tihonov-e/Integrated_Servodriver/Doc/Hall board.PNG

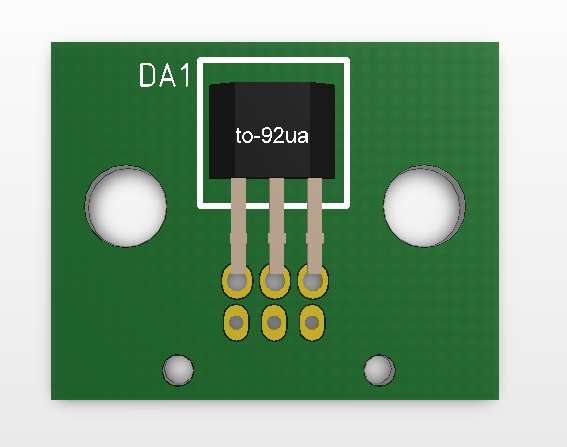
Doc/Hall board.PNG
