tihonov-e/Integrated_Servodriver/Altium Project/Supply Unit/Архив/ver.2/supply board concept.pdf

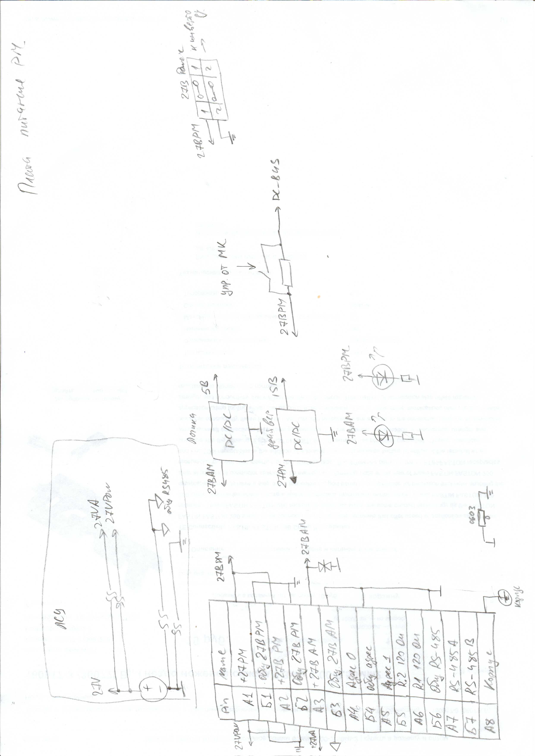
[picture p2: page 1]
