tihonov-e/Integrated_Servodriver/Расчеты/Кинематический расчет Рубеж движок ДБУ 36-3,2-24 снижение тока.pdf

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
:= | J | h

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
:= | deg
0 | 10 | 20 | 30 | 40
- 20
- 10

10

20

Циклограмма нагрузки

P
J

h
deg

Параметры РВП

Уравнение движения

hmax := max(h) = 36·deg

tmax := 0.4s

v

hmax

tmax

:= | = 15·rpm

Момент трения в подшипнике по линейной зависимости

момент трения Mbear

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
:= J

при усилиий PMb

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
:= | J
- 20 | - 10 | 0 | 10 | 20
- 1
- 0.5

0

0.5

1

Mbear

PMb

Передаточное отношение
планетарки | | i
| | cherv := 33

i

pr | 4 i
cherv := · | = 132 | η := 0.95·0.7 = 0.665 | i
pr_1 | i
pr := | = 132
лопасть | рвр до червяка черв | гайка

JΣ

0.008kg m

| 2
| ·

i
pr

2

| | 0.152 10⁻ ⁶
| | · kg m
| | 2
| + | · 3 10⁻ ⁵
| | · kg m

2
·
| | i pr

2

+

2.58 10⁻ ⁵
- kg m

2
·

i
cherv

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
·1 0.637 kg mm

2
:= | = | · ·

tmax = 0.4s

Φ(t) | 1 if t ≥ 0
| 0 otherwise

:=
20

t
1
:= 70ms | t
2

:= 70ms

ωmax1

hmax

tmax 0.5 t
1
- | · | 0.5 t
2
- ·

109.1 deg
s
:= | = | ·

ωmax

hmax i
pr ·

tmax 0.5 t
1
- | · | 0.5 t
2
- ·
:= | = 2400·rpm

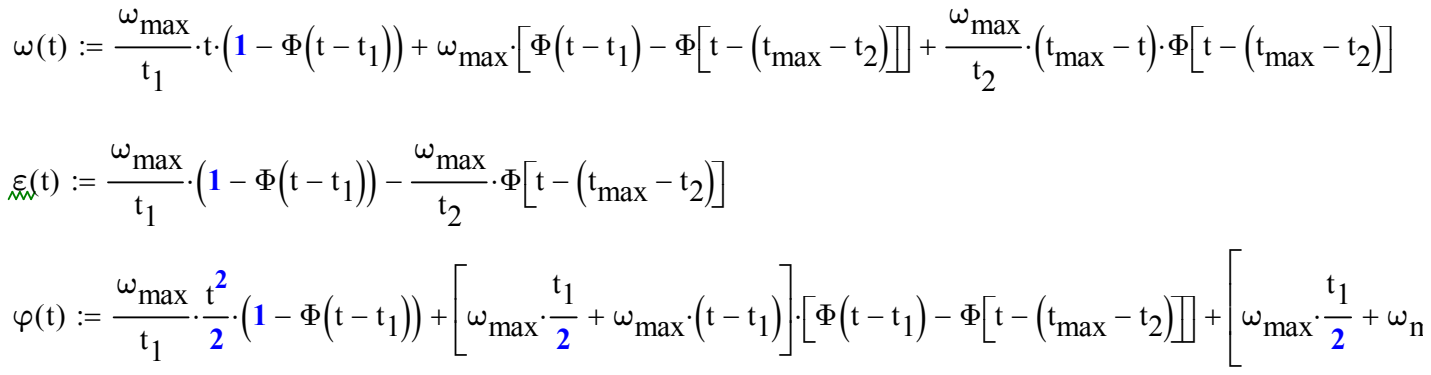
[picture p3: figure]
ωmax; ·( - ( - )) ωmax Φ t t; tmax t; tmax ·(; )) ωmax; ωmax t; · ωmax +
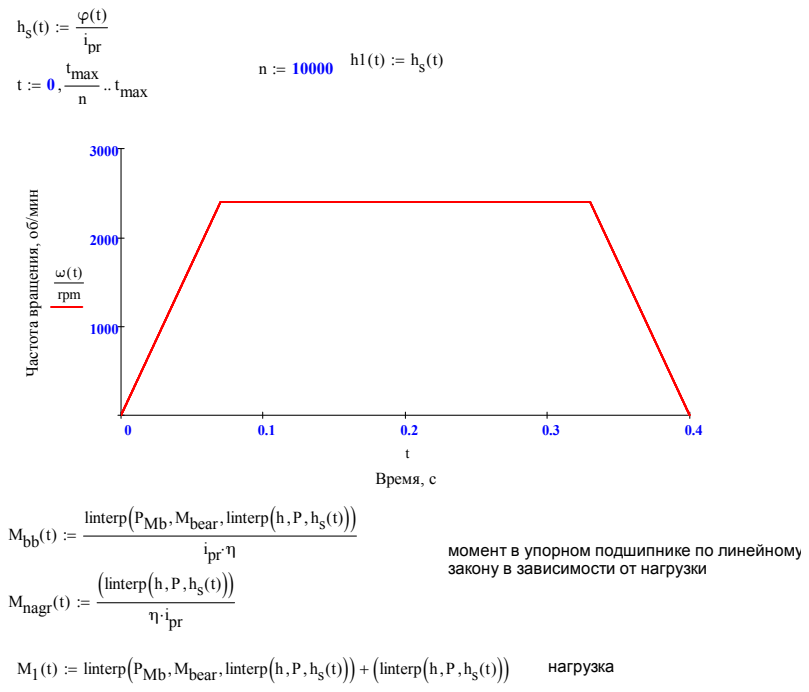
[picture p4: page 3]
tmax; tmax :=; Время, с; rpm; Mbb(t); linterp PMb Mbear ,; linterp h, P hs (; Mnagr(t); linterp h, P h; ( , (t))) linterp h, P h; нагрузка

Частота вращения, об/мин

момент в упорном подшипнике по линейному
закону в зависимости от нагрузки

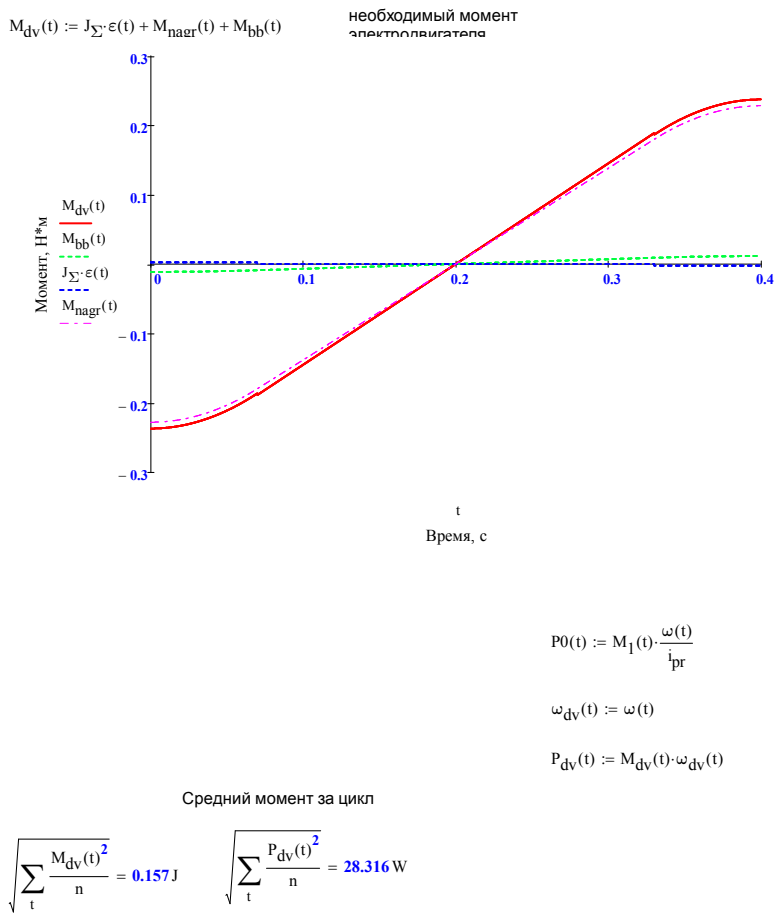
[picture p5: page 4]
необходимый момент электродвигателя; Mdv(t); Mnagr +; Mbb :=; Время, с; Момент, Н*м; Mbb(t); Mnagr(t); ωdv(t) := ω(t); Pdv(t); Mdv(t) ωdv :=

Средний момент за цикл

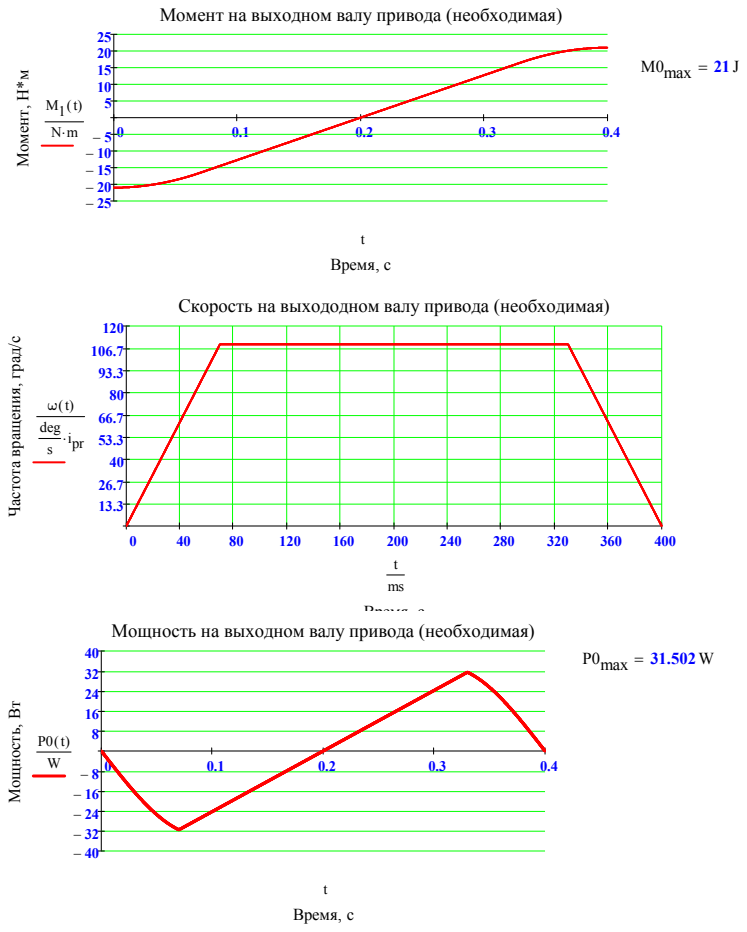
[picture p6: page 5]
Время, с; Момент, Н*м; M0max = 21 J; deg; ipr ·; Мощность на выходном валу привода (необходимая); Мощность, Вт; P0max = 31.502W

Момент на выходном валу привода (необходимая)

Скорость на выхододном валу привода (необходимая)

Частота вращения, град/с

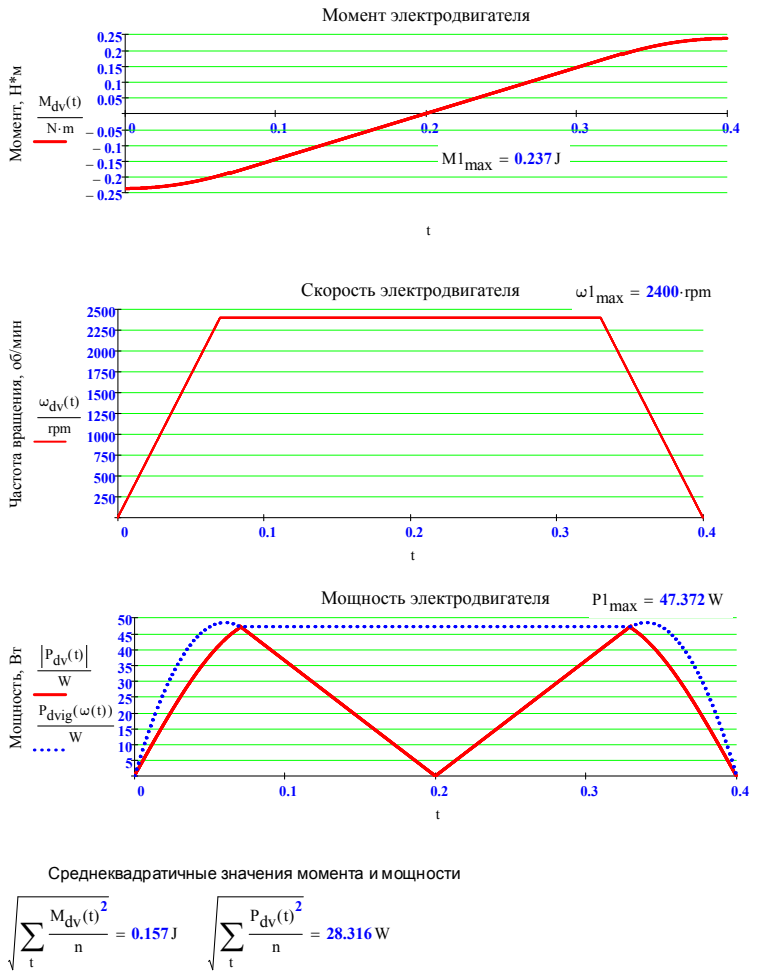
[picture p7: page 6]
Момент электродвигателя; Момент, Н*м; Mdv(t); M1max = 0.237J; Скорость электродвигателя; ωdv(t); rpm; ω1max = 2400·rpm; Мощность электродвигателя; Мощность, Вт; Pdv(t); Pdvig(ω(t)); P1max = 47.372W

Частота вращения, об/мин

Среднеквадратичные значения момента и мощности

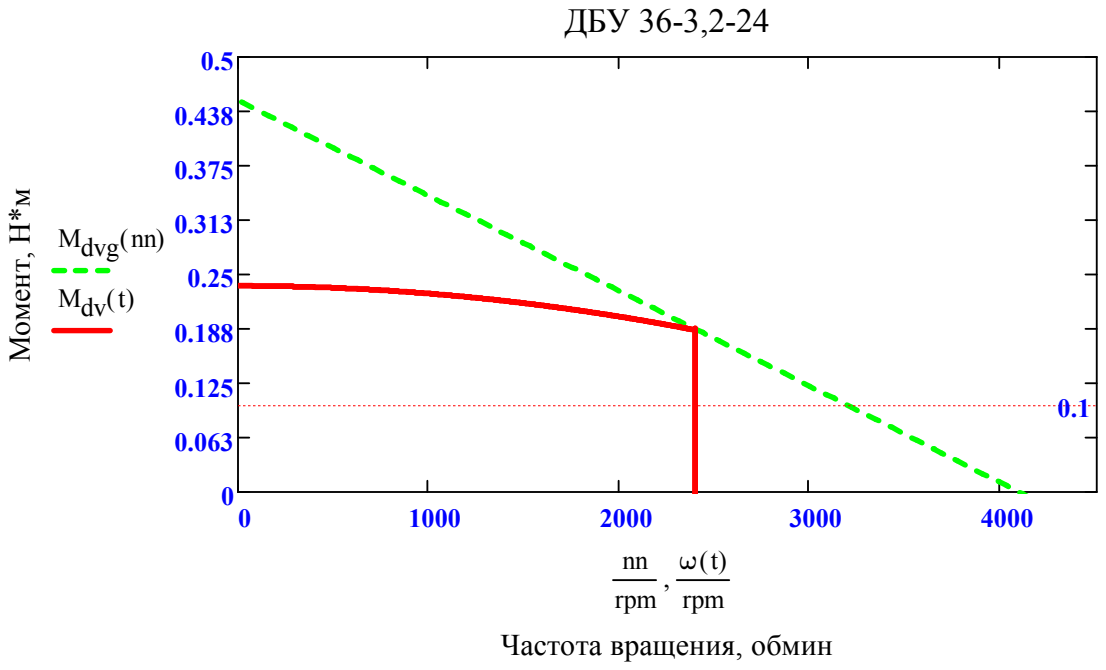
[picture p8: figure]
ДБУ 36-3,2-24; Частота вращения, обмин; Момент, Н*м; Mdvg(nn); Mdv(t); rpm

ipr_1 = 132 | передаточное отношение

максимальная мощность P1max = 47.372W

| максимальная скорость на входном валу привода
ω1max = 2400·rpm
M1max = 0.237J | максимальный момент на входном валу привода

среднеквадратичный момент на входном валу привода

t

Mdv(t)

2
∑ n
= 0.157J

среднеквадратичная мощность на входном валу привода

t

Pdv(t)

2
∑ n
= 28.316W

характеристики электродвигателя Mdvig

0.45

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
= | J | ndvig

0

3200

4100

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
= | ·rpm

мощности электродвигателя
ndvig Mdvig ·

¾¾¾¾→¾

0

33.51

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
= | W

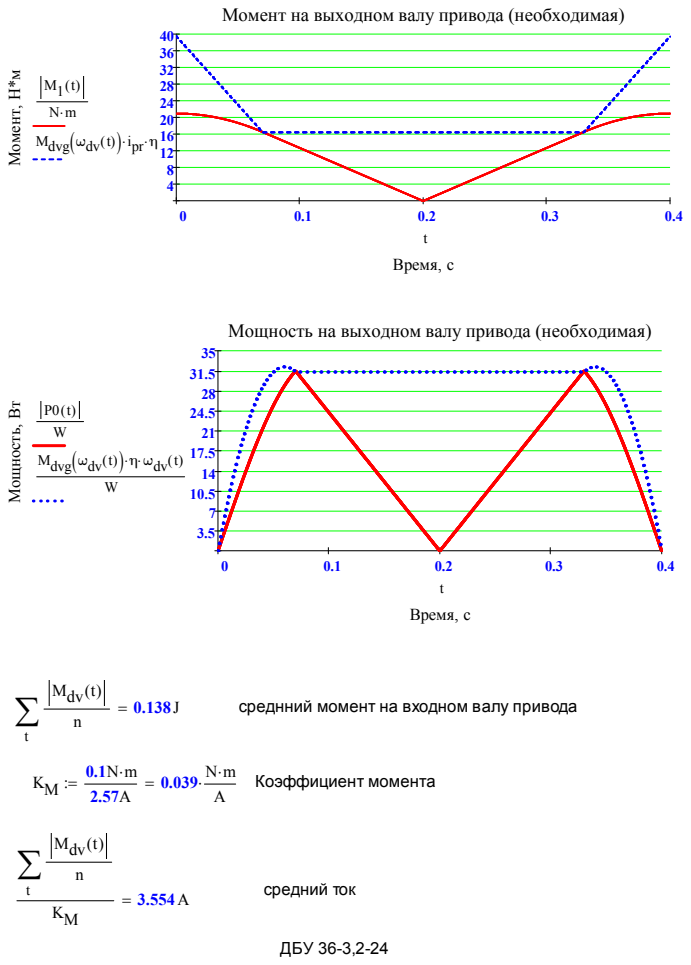
[picture p9: page 8]
Время, с; Момент, Н*м; Mdvg ωdv ( (t)) ipr ·; Мощность на выходном валу привода (необходимая); Мощность, Вт; Mdvg ωdv ( (t))·η ωdv ·; Mdv(t) ∑ n; среднний момент на входном валу привода; Коэффициент момента; средний ток; ДБУ 36-3,2-24

Момент на выходном валу привода (необходимая)

21J·90

deg
s
0.5

= 65.973W

0.98⁶

0.99⁶
- = 0.834

max

tmax

t
1

t
2

·

(

)

ωmax
t

tmax

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
ωmax
t
2

·

2

+

ùúúû

Φ
t

tmax

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
0 | 0.1 | 0.2 | 0.3 | 0.4
- 1000
- 500

500

1000

Время, с

Ускорение, 1/

с^2

ε(t)

rev

s

2

t

linterp h, P h

s ( ( , (t)))

1
0.5
- | Mbb + | (t)

Время, с

Мощность, Вт

57.687

- 57.703

Mdv(t)·ω(t)

0 | t | 0.4

Mdv

21J·90 deg
s
0.5

= 65.973W

1
tmax 0s

tmax
M | t

dv(t)

ó
ô
õ
- d = 0.138J

1
tmax 0s

tmax
M | t

dv(t)·ω(t)

ó
ô
õ
- d = 24.699W

t1 := 0.35s

ω1max := ω(ω1max) = 2400·rpm M0max := M1(M0max) = 21J

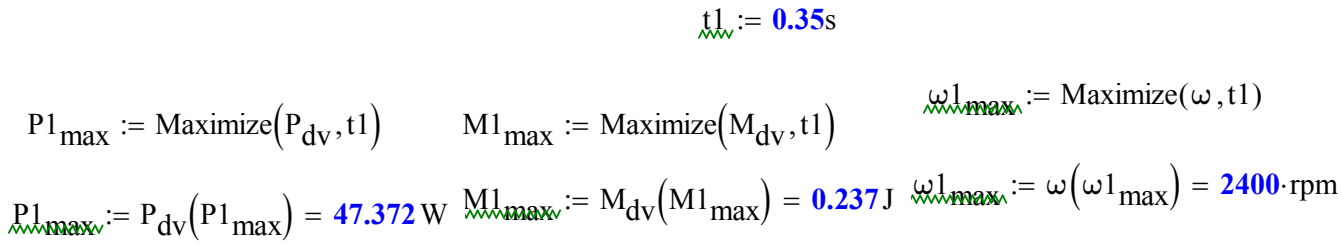
[picture p10: figure]
ω1max := Maximize(ω , t1); P1max; Maximize Pdv :=; M1max; Maximize Mdv :=; Pdv :=; (P1max) = 47.372W

ω1max := ω(ω1max) = 2400·rpm M1max := Mdv(M1max) = 0.237J

ndvig

0

3200

4100

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
:= | rpm Mdvig

0.45

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
:= | J

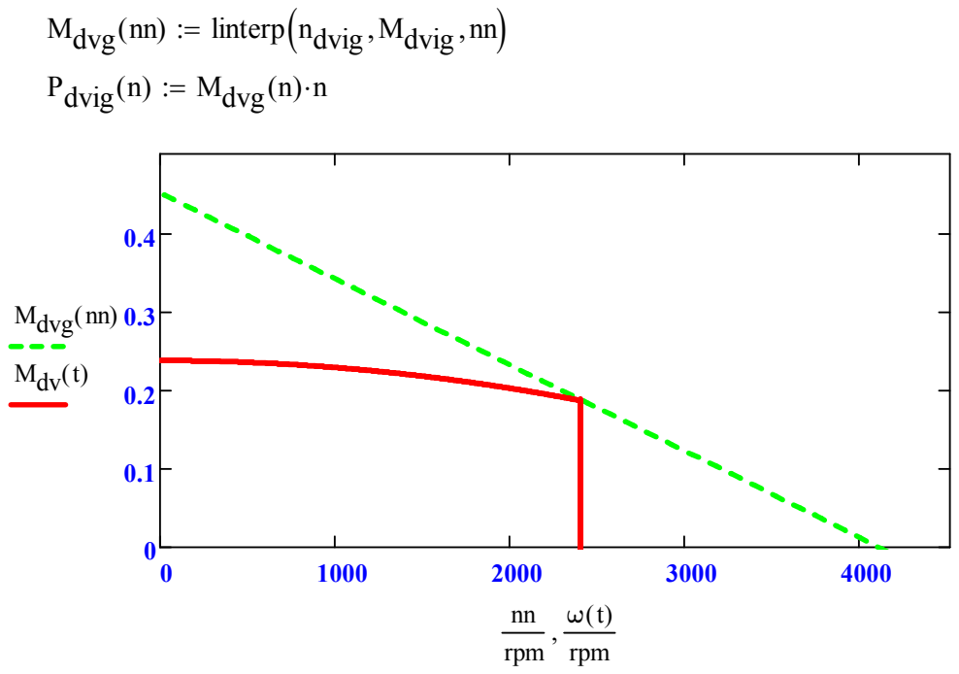
[picture p11: figure]
Mdvg(nn); linterp ndvig Mdvig :=; Pdvig(n); Mdvg :=; Mdv(t); rpm
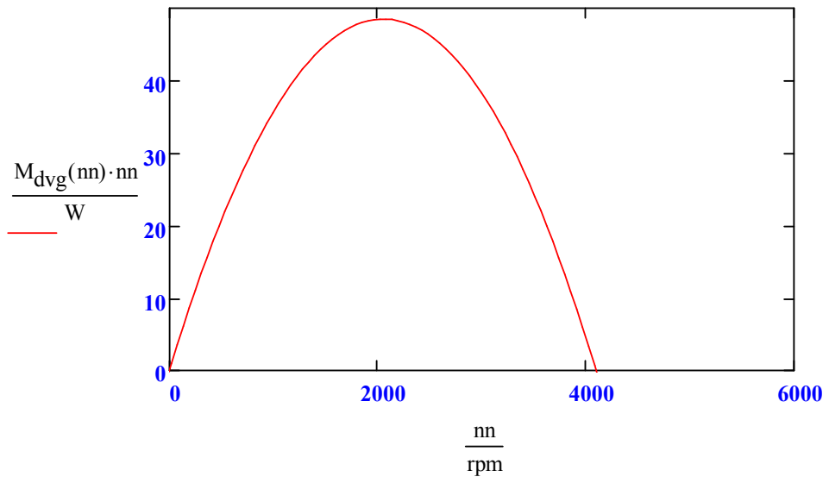
[picture p12: figure]
Mdvg(nn)·nn; rpm

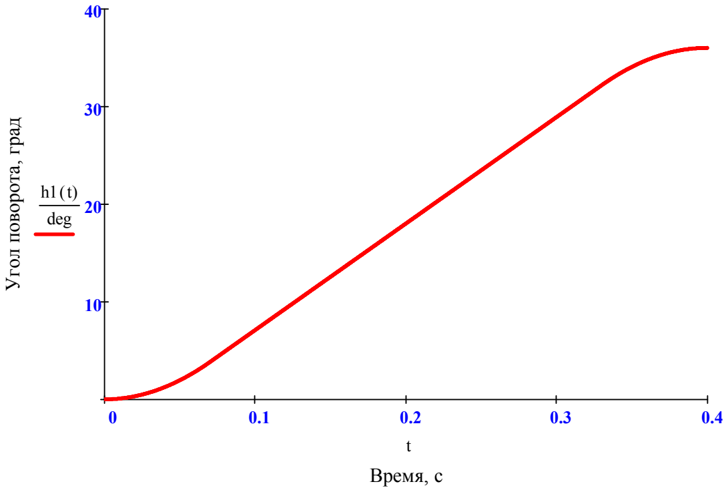
[picture p13: figure]
Время,; Угол поворота, град; deg

6800rpm·0.043J = 30.62W
