tihonov-e/Integrated_Servodriver/Doc/Структура МУ.pdf

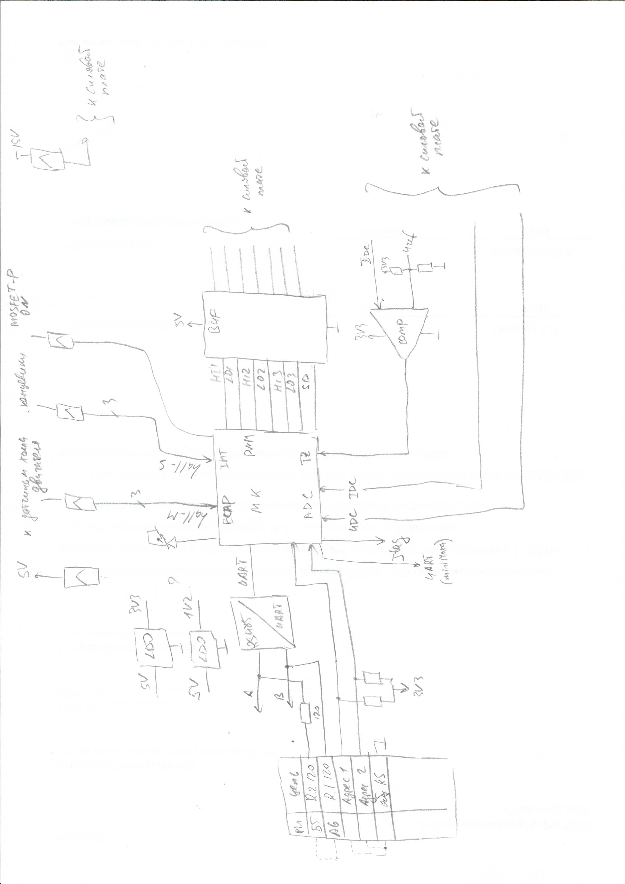
[picture p14: page 1]
