tihonov-e/Integrated_Servodriver/Расчеты/Графики нагрузки от Матвева/Максимальная нагрузка.jpeg

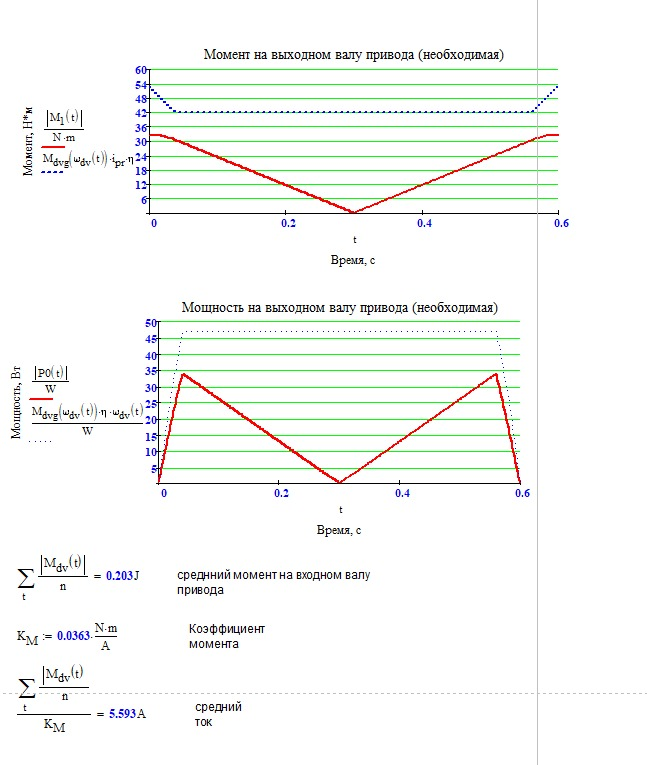
Расчеты/Графики нагрузки от Матвева/Максимальная нагрузка.jpeg
