tihonov-e/Integrated_Servodriver/Расчеты/Графики нагрузки от Матвева/Номинальная нагрузка.jpeg

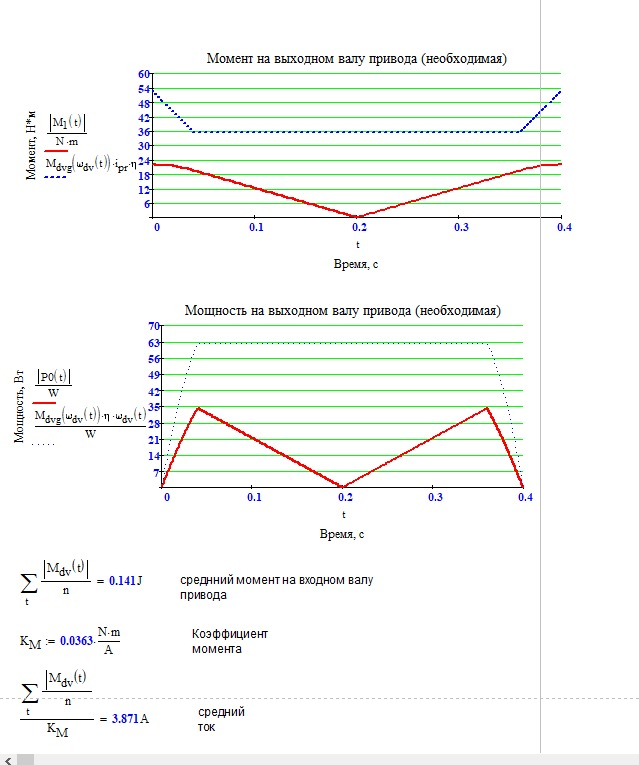
Расчеты/Графики нагрузки от Матвева/Номинальная нагрузка.jpeg
