tihonov-e/Integrated_Servodriver/Altium Project/Power Unit/Project Outputs for Power_unit-RM/Power_unit-RM.xls

Designator | PartNumber | Quantity | Manufacturer | MAX | Analog
C1, C2, C3 | К53-68 "С"-25 В-10 мкф ±10% | 3 | Элеконд
C4, C8, C15, C19, C32, C36 | К10-84в-3225М-25~В-Н20-1 мкФ-O-A ±10% ФЦТА.673516.016 ТУ | 6 | Monolit
C6, C10, C17, C21, C34, C38 | К10-84в-2012М-50В-0,1 мкФ +80/-20%-Н90-N-A | 6 | Монолит |  | 00131672 (pin-to-pin)
C7, C18, C35 | K73-17-63В-0,22мкФ±10%-В АЖЯР.673633.004 ТУ | 3 | Гириконд
C11, C12 | K50-93-63В-100мкФ ±20% -И-В АЖЯР.673541.021 ТУ | 2 | Элеконд | 00139211
C13, C24, C39 | К53-68 "А"-10 В-4.7 мкф | 3 | Элеконд | 00130629
C14, C23, C30, C40 | К10-79-10В-0,1 мкФ +80-20% H90 | 4 | Гириконд | 00131675
C22, C25, C26, C28, C29 | К10-84в-1608М-50В-0.01мк ±20%-Н20-N-A | 5 | Монолит |  | MAX 00131676 (pin-to-pin), MAX 00132726 (pin-to-pin), MAX 00131676 (pin-to-pin), MAX 00131676 (pin-to-pin), MAX 00131676 (pin-to-pin)
C27, C31 | К10-84в-1608М-50В-47 пФ ±10%-МП0-N-A | 2 | Монолит |  | 00124425 (pin-to-pin)
DA1 |  | 1 | НПП "Восток" | 00135502 | OP284FS
DD1, DD2, DD3 | 1308ЕУ4АУ | 3 | Кремний Эл | 00131005 | IR2113 IR
R1, R10, R29 | Р1-12-0,1ум.-10~Ом ±2%-М ШКАБ.434110.002 ТУ | 3 | ОАО Ресурс | 00133989
R2, R3, R4, R6, R9, R11, R12, R14, R21, R32, R33, R35, R37 | Р1-12-0,1ум.-10~кОм ±5%-М ШКАБ.434110.002 ТУ | 13 | ОАО Ресурс |  | MAX 00133986 (1%)
R5, R8, R13, R20, R34, R36 | Р1-12-0,125-20 Ом ±5%-М ШКАБ.434110.002 ТУ | 6 | ОАО Ресурс |  | MAX 00133867 (22Ом)
R7 | Р1-12-0,125-10~кОм ±1%-М ШКАБ.434110.002 ТУ | 1 | ОАО Ресурс | 00134578
R15, R16 | Р1-12-0,1ум.-28~кОм ±5%-М ШКАБ.434110.002 ТУ | 2 | ОАО Ресурс | 00134035
R17, R23, R25, R30 | Р1-12-0,1ум.-100~Ом ±5%-М ШКАБ.434110.002 ТУ | 4 | ОАО Ресурс | 00133991
R18 | Р1-12-0,1ум.-4.02~кОм±1%-М ШКАБ.434110.002 ТУ | 1 | ОАО Ресурс | 00134054
R19, R24, R28 | Р1-12-0,1ум.-1~кОм ±1%-М ШКАБ.434110.002 ТУ | 3 | ОАО Ресурс | 00133971
R22, R31 | Р1-12-0,1ум.-2.61~кОм±1%-М ШКАБ.434110.002 ТУ | 2 | ОАО Ресурс | 00134019
R26, R27 | Р2-105-0,75-0,1 Ом±1% А РМУ.434150.001 ТУ | 2 | Эркон | 00149850
VD1, VD5, VD7, VD9, VD11, VD15, VD16, VD17, VD18, VD19, VD20 | 2ДШ205А9 | 11 | ВЗПП Воронеж |  | MBR0580
VD2, VD6, VD12 | 2РС202Е91 | 3 | ВЗПП |  | SMBJ48CA (pin-to-pin)
VD3, VD4, VD8, VD10, VD13, VD14 | 2Р192В9 | 6 | КРИП |  | КР192А9 (ОТК) (pin-to-pin)
VT1, VT2, VT3, VT4, VT5, VT6 | 2ПЕ208В92 | 6 | Ангстрем |  | AnD28N10
XP1 | СНП401-6ВП21-3-1-1 | 1 | Электродеталь |  | MAX 00126397 (M80-5000605 pin-to-pin)
XP2 | СНП393-18ВП31-2-01-5 РЮМК.430420.035 ТУ | 1 | Электродеталь |  | MAX 000724477 (PLD-80R с доработкой до 18pin)
XT1 | СКПП-0.5-2.54У-3x2-2 СЦНК.434410.044 ТУ | 1 | Завод Атлант |  | 233-403 Wago
