tihonov-e/Integrated_Servodriver/Altium Project/Supply Unit/Project Outputs for Supply_unit-RM/Supply_unit-RM.xls

Designator | PartNumber | Value | Manufacturer | Quantity | MAX | Analog
C1, C8 | К53-68 "E"-50 В-10мкф ±10% | 10мк | Элеконд | 2 | 00145440 | 00132739 (pin-to-pin на 15мкФ)
C2, C9 | К53-68 "D"-25 В-22мкф ±10% | 22мк | Элеконд | 2 | 00132735
C3, C6 | К10-84в-3225М-25В-0,47 мкФ ±10%-Н20-N-A | 0.47мк | Монолит | 2 |  | MAX 00150226
C4, C5, C7, C10 | К10-84в-1608М-50В-10 нФ ±10%-Н20-N-A | 10000 | Монолит | 4
R1, R7, R12 | Р1-12-0,1ум.-3.16~кОм ±1%-М ШКАБ.434110.002 ТУ | 3.16k | ОАО Ресурс | 3 | 00134464
R3 | Р1-12-0,1ум.-0.15~Ом ±20%-М ШКАБ.434110.002 ТУ | 0.15 | ОАО Ресурс | 1 | 00133968 | MAX 00117169 pin-to-pin
R4, R13 | Р1-12-0,1ум.-10~кОм ±5%-М ШКАБ.434110.002 ТУ | 10k | ОАО Ресурс | 2 |  | MAX 00133986 (1%)
R8 | Р1-12-0,1ум.-680~Ом ±5%-М ШКАБ.434110.002 ТУ | 680 | ОАО Ресурс | 1 | 00134086
R9 | Р1-12-0,125-680 Ом ±5%-М ШКАБ.434110.002 ТУ | 680 | Ресурс | 1 | 00133924
R10, R11 | Р1-12-0,1ум.-4.02~кОм ±1%-М ШКАБ.434110.002 ТУ | 4.02k | ОАО Ресурс | 2 | 00123886
U1 | МДМ5-1В15НН |  | Aedon | 1
U2 | МДМ3-1В05НН |  | Aedon | 1
VD1, VD3 | 2Р245Е91 |  | НЗПП | 2 |  | SMA6J33A
VD5, VD6 | ИПД169А9-Л |  | Протон | 2 |  | MAX 00129484 КР-1608 Kingbright (pin-to-pin)
VD7 | 2Р192В9 |  | КРИП | 1 |  | КР192А9 (ОТК) (pin-to-pin)
VT1 | 2ПЕ209Б92 |  | Ангстрем | 1 |  | SUD50P06-15 (pin-to-pin)
VT2 | 2Т3130Б9 |  | ООО НПК Далекс | 1 | 00123842
VT3 | 2Т3129Б9 |  |  | 1 | 00123135
XP1 | СНП401-6ВП21-3-1-1 |  | Электроделать | 1 |  | MAX 00126397 (M80-5000605 pin-to-pin)
XP2 | СНП401-16ВП21-3-1-1 |  | Электродеталь | 1 |  | MAX 00139241 [М80-5101605] (pin-to-pin)
XP3 | СНП401-10ВП21-3-1-1 |  | Электродеталь | 1 |  | MAX 00126377 (M80-5001042 pin-to-pin)
XP4 | СНП377-1ВП21-1 |  | Электродеталь | 1 |  | PLS2-1
