tihonov-e/Integrated_Servodriver/Altium Project/Control Unit/Project Outputs for Control_unit-RM/Control_unit-RM.xls

Designator | PartNumber | Manufacturer | Quantity | MAX | Analog
C1, C30 | К53-68 "А"-10 В-4.7 мкф | Элеконд | 2 | 00130629
C2, C3 | К10-84в-1608М-50В-10 пФ ±5%-МП0-N-A | Монолит | 2 |  | 00133079 (pin-to-pin)
C4, C5, C6, C7, C9, C10, C11, C13, C14, C15, C18, C20, C22, C27, C29 | К10-79-10В-0,1 мкФ +80-20% H90 | Гириконд | 15 | 00131675
C8 | К10-84в-1608М-25В-220 нФ +80/-20%-Н90-N-A | Монолит | 1 |  | MAX 00131682 (pin-to-pin)
C12, C19, C25, C26, C28, C31 | К10-84в-1608М-50В-2200 пФ ±10%-Н20-N-A | Монолит | 6 |  | MAX 00132726 (pin-to-pin)
C16, C17, C23, C24 | К10-84в-4532М-25В-4,7 мкФ +80/-20%-Н90-N-A | Монолит | 4
C21 | К53-68 В-10 В-15 мкФ ±10% | "Элеконд" | 1
DA1 | 5545СА2У3 | НПП ВОСТОК | 1 |  | LM2903D
DA2 | 1325ЕН3.3У | Интеграл | 1 | 00141284
DD1 | 1921ВК035 | НИИЭТ | 1
DD2 | 1594АП5Т | Интеграл | 1 | 00135879
DD3 | 5559ИН28У | Миландр | 1
L1, L2 | КИФ1608-1000 нГн ±20% О-А РКМУ.671340.002 ТУ | ЭРКОН | 2
R1 | Р1-12-0,1ум.-1~МОм ±5%-М ШКАБ.434110.002 ТУ | ОАО Ресурс | 1 | 00133970
R2, R4, R6 | Р1-12-0,1ум.-22~Ом ±5%-М ШКАБ.434110.002 ТУ | ОАО Ресурс | 3 | 00134024
R3, R28 | Р1-12-0,1ум.-680~кОм ±5%-М ШКАБ.434110.002 ТУ | ОАО Ресурс | 2 | 00134086
R5, R7, R8, R9, R11, R12, R13, R14, R15, R16, R17, R20, R22, R25, R26, R29, R32, R33, R35, R36, R38, R39, R40, R41, R45, R47, R49 | Р1-12-0,1ум.-10~кОм ±5%-М ШКАБ.434110.002 ТУ | ОАО Ресурс | 27 |  | MAX 00133986 (1%)
R10 | Р1-12-0,1ум.-100~кОм ±5%-М ШКАБ.434110.002 ТУ | ОАО Ресурс | 1 |  | MAX 00122851
R18, R21, R24 | Р1-12-0,1ум.-100~Ом ±5%-М ШКАБ.434110.002 ТУ | ОАО Ресурс | 3 | 00133991
R19, R23, R27, R31, R44, R46 | Р1-12-0,1ум.-1~кОм ±1%-М ШКАБ.434110.002 ТУ | ОАО Ресурс | 6 | 00133971
R30, R34, R37, R42, R48 | Р1-12-0,1ум.-3.9~кОм ±5%-М ШКАБ.434110.002 ТУ | ОАО Ресурс | 5 | 00134467
R43 | Р1-12-0.125-120 Ом±5%-М | Русские | 1 | 00133848
VD1, VD2 | ИПД169А9-Л | Протон | 2 |  | MAX 00129484 КР-1608 Kingbright (pin-to-pin)
VD3, VD4 | 2Д707Б9 | КРИП | 2 |  | BAS16
VT1, VT2, VT3, VT4, VT5, VT6 | 2Т3130Б9 | ООО НПК Далекс | 6
XP1 | СНП391-5ВП21-1 РЮМК.430420.036 ТУ | Электроделать | 1 |  | PLL1.27 (MAX 00150250 с доработкой до 5 пинов)
XP2 |  | ОАО "Карачевский завод "Электродеталь" | 1 | 00123938 | PBD2-8
XP3 | СНП391-2ВП21-1 РЮМК.430420.036 ТУ | ОАО "Карачевский завод "Электродеталь" | 1 |  | PLL1.27 (MAX 00150250 с доработкой до 2 пинов)
XP4 | СНП401-12ВП21-4-1-1 | Электродеталь | 1 |  | MAX 00138662 [М80-5101205] (pin-to-pin)
XP5 | СНП401-10ВП21-4-1-1 | Электродеталь | 1 |  | MAX 00126377 (M80-5001042 pin-to-pin)
XS1 | СНП393-20РП21-2 РЮМК.430420.035 ТУ | Электродеталь | 1 |  | MAX 00135030 с доработкой до 16-pin
ZQ1 | SMD РК386М-Т1-4ВН-12М-В 6321-004-07614320-96 ТУ | ОАО "Морион" | 1 | 00149842
