tihonov-e/Integrated_Servodriver/Altium Project/Supply Unit/Архив/ver.2/Project Outputs for Supply_unit-RM/Supply_unit-RM.xls

Designator | PartNumber | Value | Manufacturer | Quantity | MAX | Analog
C1, C5 | К10-84в-1608М-50В-0,01 мкФ ±10%-Н20-N-A | 0.01мк | Монолит | 2 |  | MAX 00123301 (K10-17в - 0805)
C2, C6, C8 | К10-84в-2012М-50В-0,1 мкФ +80/-20%-Н90-N-A | 0.1мк | Монолит | 3 |  | MAX 00123747 (К10-17в - с1206)
C3, C7 | К53-68 "E"-50 В-10мкф ±10% | 10мк | Элеконд | 2 | 00145440 | 00132739 (pin-to-pin на 15мкФ)
C4 | К53-68 "E"-25 В-68мкф ±10% | 68мк | Элеконд | 1 | 00145468
C9 | К53-68 "E"-16 В-100 мкф ±10% | 100мк | Элеконд | 1 | 00129948
DA1, DA2 | 1273ПН1T1 |  | НИИЭТ | 2 |  | LM2675-ADJ
L1, L2 | ДФПК7,5-2/0.8 | 260 мк | АЛЕКСАНДЕР ЭЛЕКТРИК | 2
R1, R7, R12 | Р1-12-0,1ум.-3.16~кОм ±1%-М ШКАБ.434110.002 ТУ | 3.16k | ОАО Ресурс | 3 | 00134464
R2, R6 | Р1-12-0,1ум.-1~кОм ±1%-М ШКАБ.434110.002 ТУ | 1k | ОАО Ресурс | 2 | 00133971
R3 | Р1-12-0,1ум.-0.15~Ом ±5%-М ШКАБ.434110.002 ТУ | 0.15 | ОАО Ресурс | 1 | 00133968 | MAX 00117169 pin-to-pin
R4, R13 | Р1-12-0,1ум.-10~кОм ±5%-М ШКАБ.434110.002 ТУ | 10k | ОАО Ресурс | 2 | 00133986
R5 | Р1-12-0,1ум.-11.3~кОм ±1%-М ШКАБ.434110.002 ТУ | 11.3k | ОАО Ресурс | 1 |  | 00133993 (pin-to-pin 11k 5%)
R8 | Р1-12-0,1ум.-680~кОм ±5%-М ШКАБ.434110.002 ТУ | 680 | ОАО Ресурс | 1 | 00134086
R9 | Р1-12-0,125-680 Ом ±5%-М ШКАБ.434110.002 ТУ | 680 | Ресурс | 1 | 00133924
R10, R11 | Р1-12-0,1ум.-4.02~кОм ±5%-М ШКАБ.434110.002 ТУ | 4.02k | ОАО Ресурс | 2 |  | 00123886
VD1, VD3 | 2Р245Е91 |  | НЗПП | 2 |  | SMA6J33A
VD2, VD4 | 2ДШ2123Д95 |  | ВЗПП Сборка Воронеж | 2 |  | 00136260 только для макета (pin-to-pin)
VD5, VD6 | ИПД169А9-Л |  | Протон | 2 |  | MAX 00129484 КР-1608 Kingbright (pin-to-pin)
VD7 | 2Р192В9 |  | КРИП | 1 |  | КР192А9 (ОТК) (pin-to-pin)
VT1 | 2ПЕ209Б92 |  | Ангстрем | 1 |  | SUD50P06-15 (pin-to-pin)
VT2 | 2Т3130Б9 |  | ООО НПК Далекс | 1
XP1 | СНП401-10ВП21-4-1-1 |  | Электроделать | 1 |  | MAX 00126397 (M80-5000605 pin-to-pin)
XP2 | СНП401-16ВП21-4-1-1 |  | Электродеталь | 1 |  | MAX 00139241 [М80-5101605] (pin-to-pin)
XP3 | СНП401-10ВП21-4-1-1 |  | Электродеталь | 1 |  | MAX 00126377 (M80-5001042 pin-to-pin)
