tihonov-e/Integrated_Servodriver/Doc/supply_unit.pdf

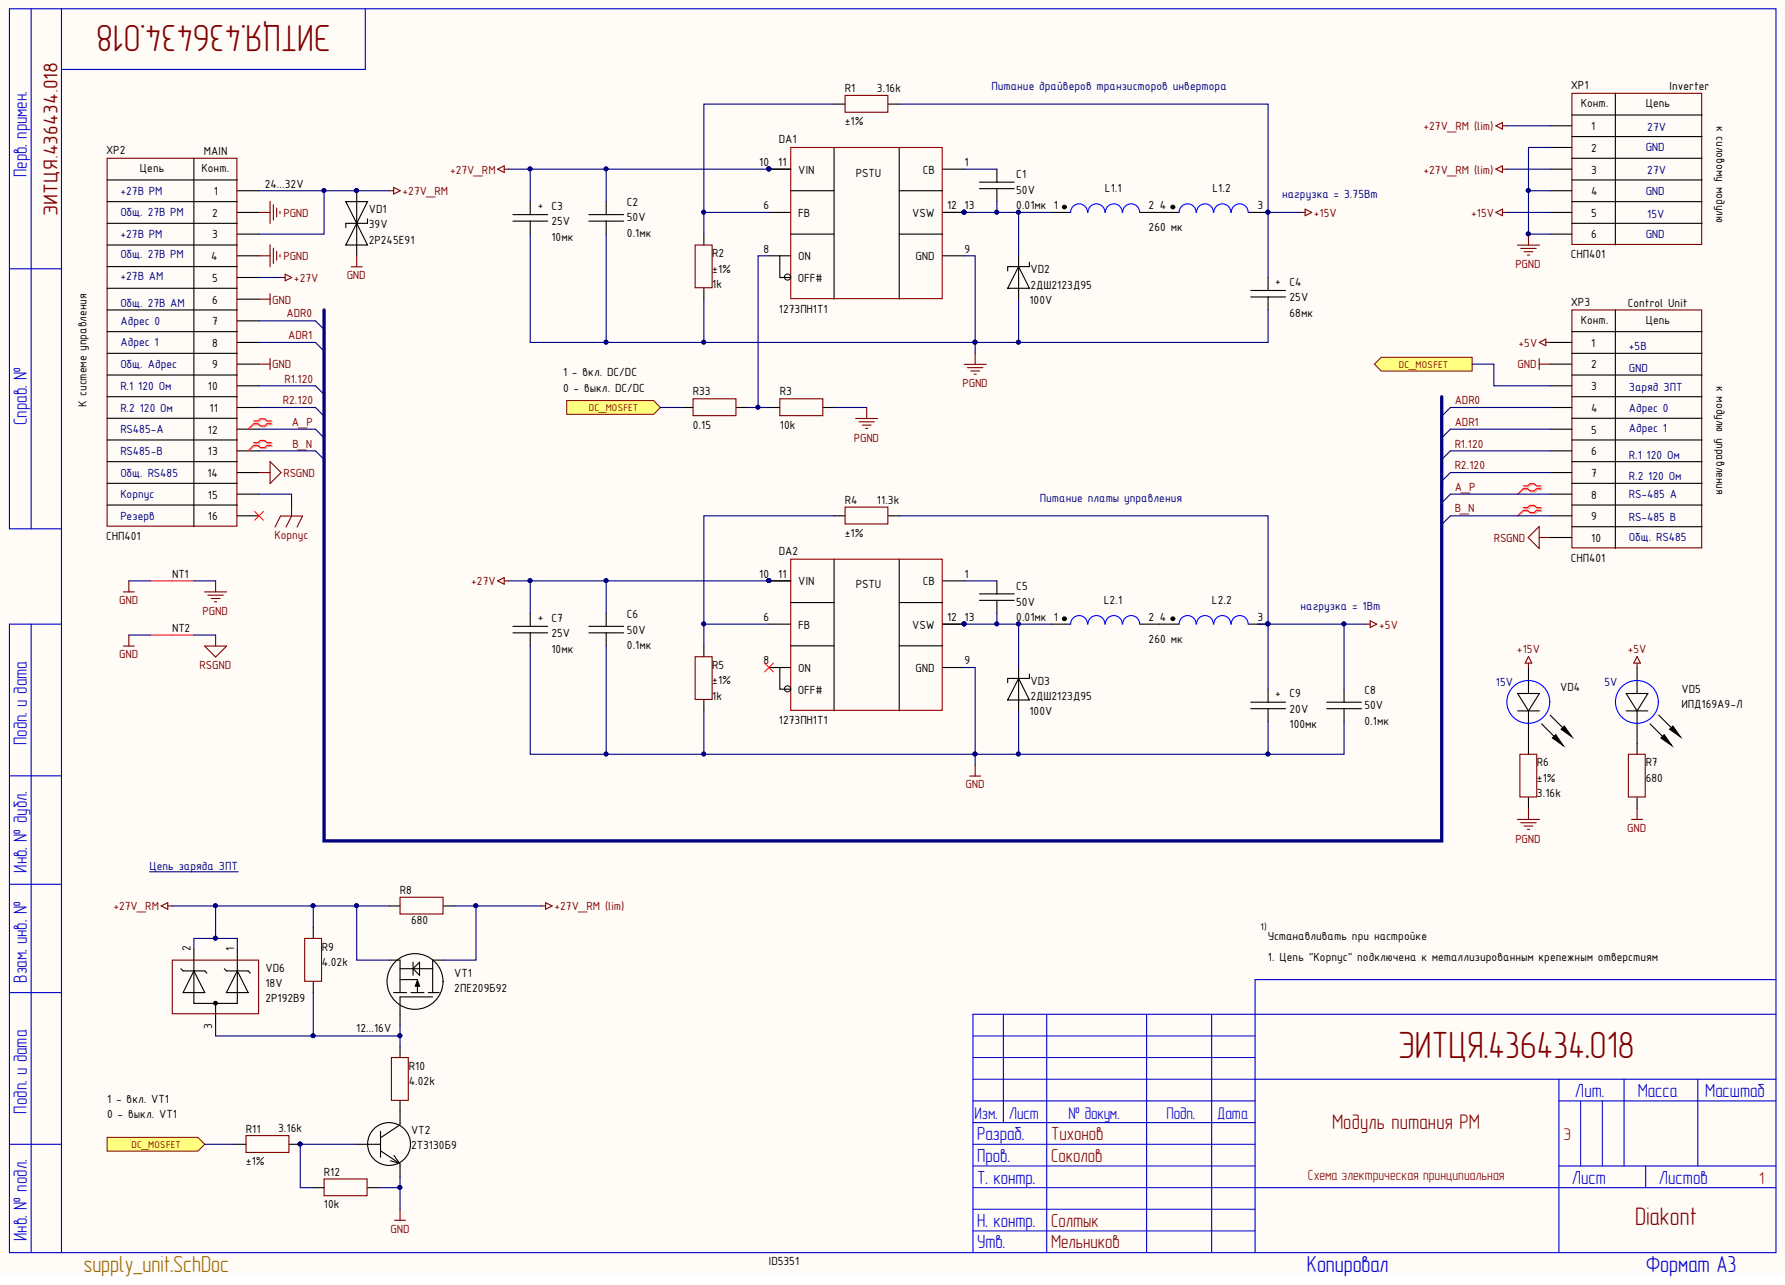
[picture p17: page 1]

Питание драйверов транзисторов инвертора

Инв. № подл. Подп. и дата Взам. инв. № Инв. № дубл. Подп. и дата Справ. № Перв. примен.

Общ. 27В РМ | 4
+27В АМ | 5 | GND

Общ. 27В АМ | 6

1. Цепь "Корпус" подключена к металлизированным крепежным отверстиям

Изм. | Лист | № докум. | Подп. | Дата
Разраб. | | Тихонов

Т. контр.

Н. контр. | Солтык
