tihonov-e/Integrated_Servodriver/Doc/Search/D661493.pdf

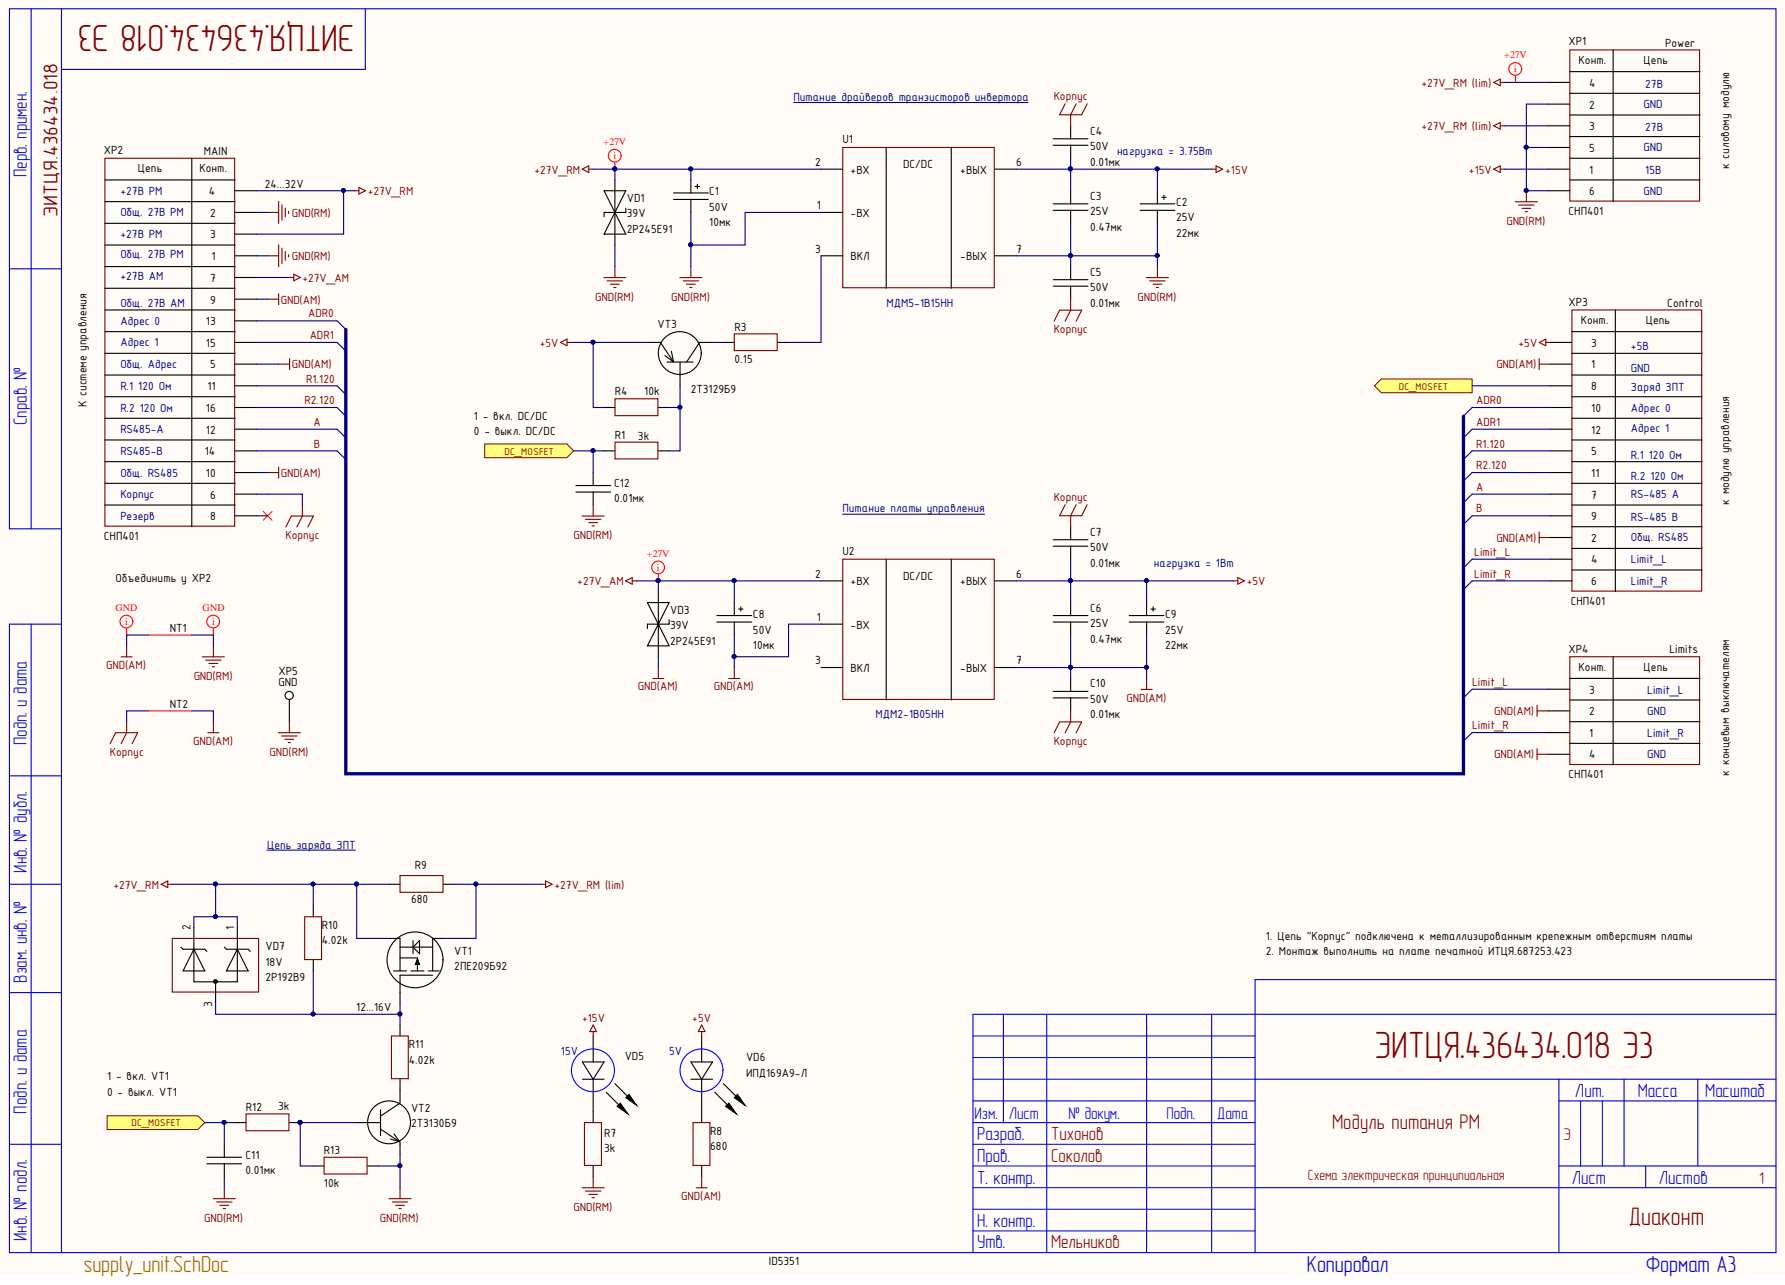
[picture p18: page 1]

Конт . | Цепь

3456 | В
401 12 | G N D

27 В
G N D

Инв. № подл. Подп. и дата Взам. инв. № Инв. № дубл. Подп. и дата Справ. № Перв. примен.

Питание драйверов транзисторов инвертора Питание платы управления

В Х -В Х В К Л | DC/D C | + ВЫХ -ВЫХ

Общ . 27 В АМ | 3456789

R S-485 B
Общ . R S 485

Limi t_L

+ В Х -В Х В К Л | DC/D C | + ВЫХ -ВЫХ

Limi t_R

34 | G N D
401 12 | Limi t_R

t_R GND(AM) GND(AM)
Limi

Изм . | Л и с т | № д о к у м . | По д п . | Д ата
Разраб . | | Тихонов
Пров . | | Соколов
Т . контр .

Н . контр .
