tihonov-e/Integrated_Servodriver/Doc/Search/D661496.pdf

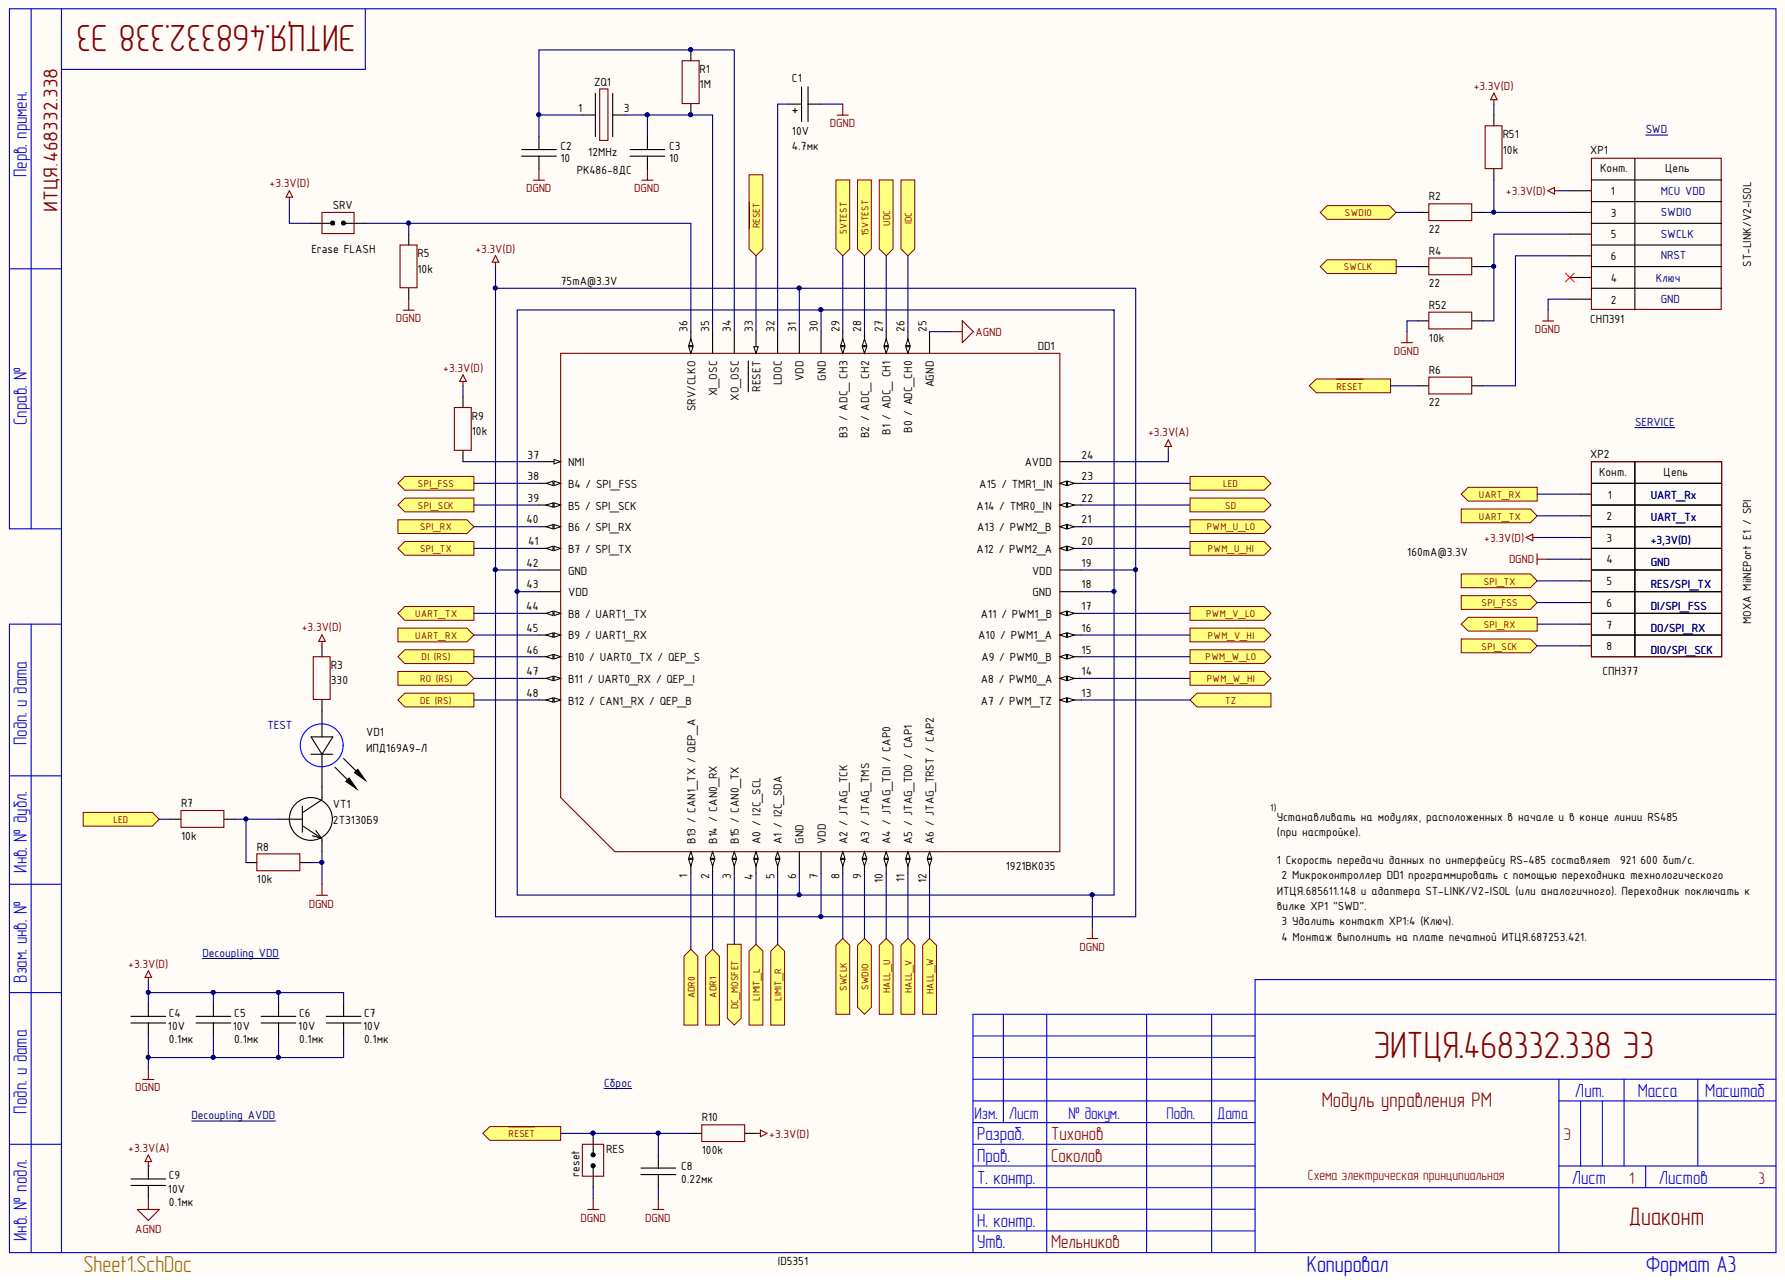
[picture p19: page 1]

Инв. № подл. Подп. и дата Взам. инв. № Инв. № дубл. Подп. и дата Справ. № Перв. примен.

6 | NRST

4 | Ключ

2 | GND

Устанавливать на модулях, расположенных в начале и в конце линии RS485
(при настройке).

1 Скорость передачи данных по интерфейсу RS-485 составляет 921 600 бит/с.
2 Микроконтроллер DD1 программировать с помощью переходника технологического
ИТЦЯ.685611.148 и адаптера ST-LINK/V2-ISOL (или аналогичного). Переходник поключать к
вилке XP1 "SWD".
3 Удалить контакт XP1:4 (Ключ).
4 Монтаж выполнить на плате печатной ИТЦЯ.687253.421.

Изм. | Лист | № докум. | Подп. | Дата
Разраб. | | Тихонов
Пров. | | Соколов
Т. контр.

Н. контр.

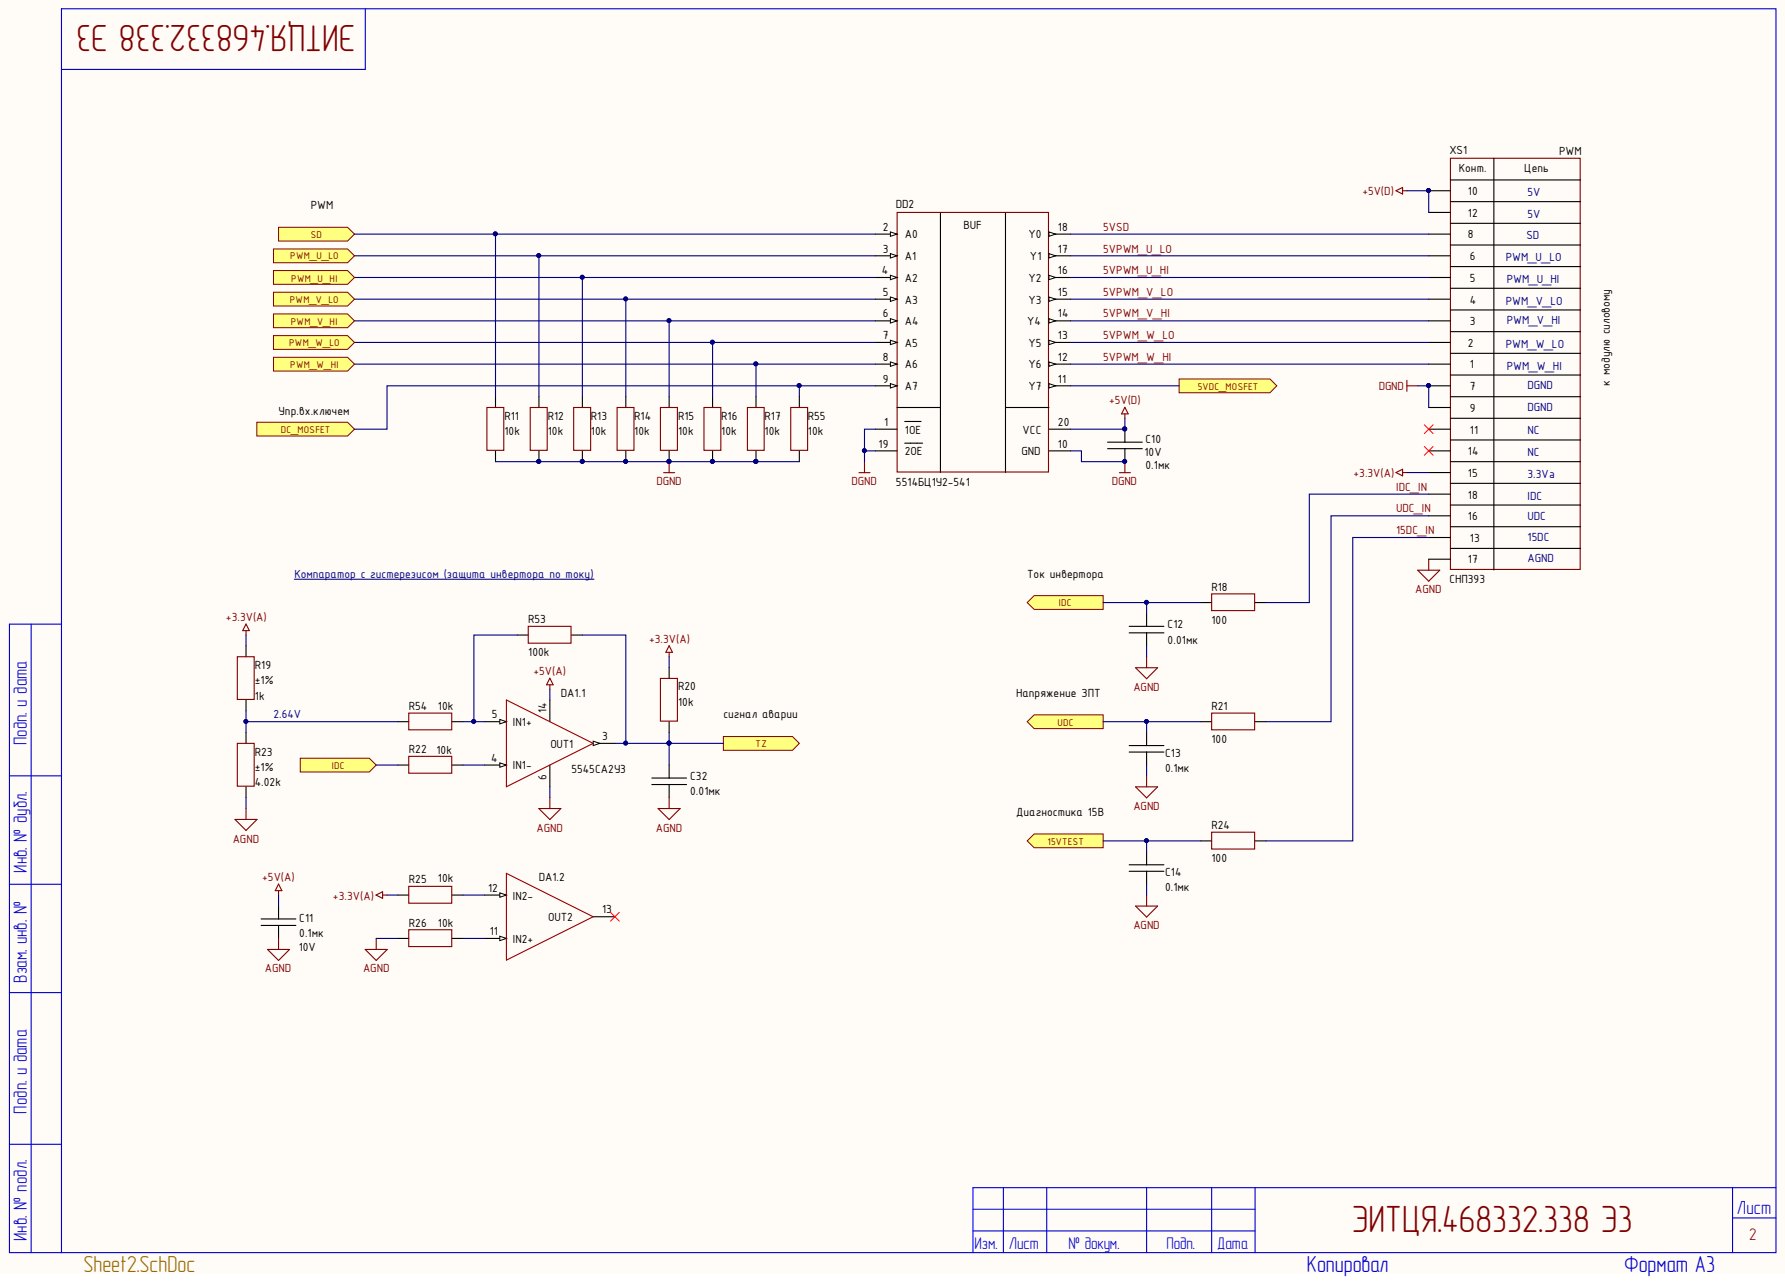
[picture p20: page 2]

Конт. | Цепь

BUF A0 2 | Y1 Y2 Y3 Y4 Y5 Y6

A1 3 | | | 17 5VPWM_U_LO

A2 4 | | | 16 5VPWM_U_HI

6 | PWM_U_LO

5 | PWM_U_HI

A3 5 | | | 15 5VPWM_V_LO

4 | PWM_V_LO
3 | PWM_V_HI

A4 6 | | | 14 5VPWM_V_HI

A5 7 | | | 13 5VPWM_W_LO

A6 8 | | | 12 5VPWM_W_HI

2 | PWM_W_LO

1 | PWM_W_HI
7 | DGND

9 | DGND

18 | IDC

UDC_IN

16 | UDC

17 | AGND

Компаратор c гистерезисом (защита инвертора по току)

Инв. № подл. Подп. и дата Взам. инв. № Инв. № дубл. Подп. и дата

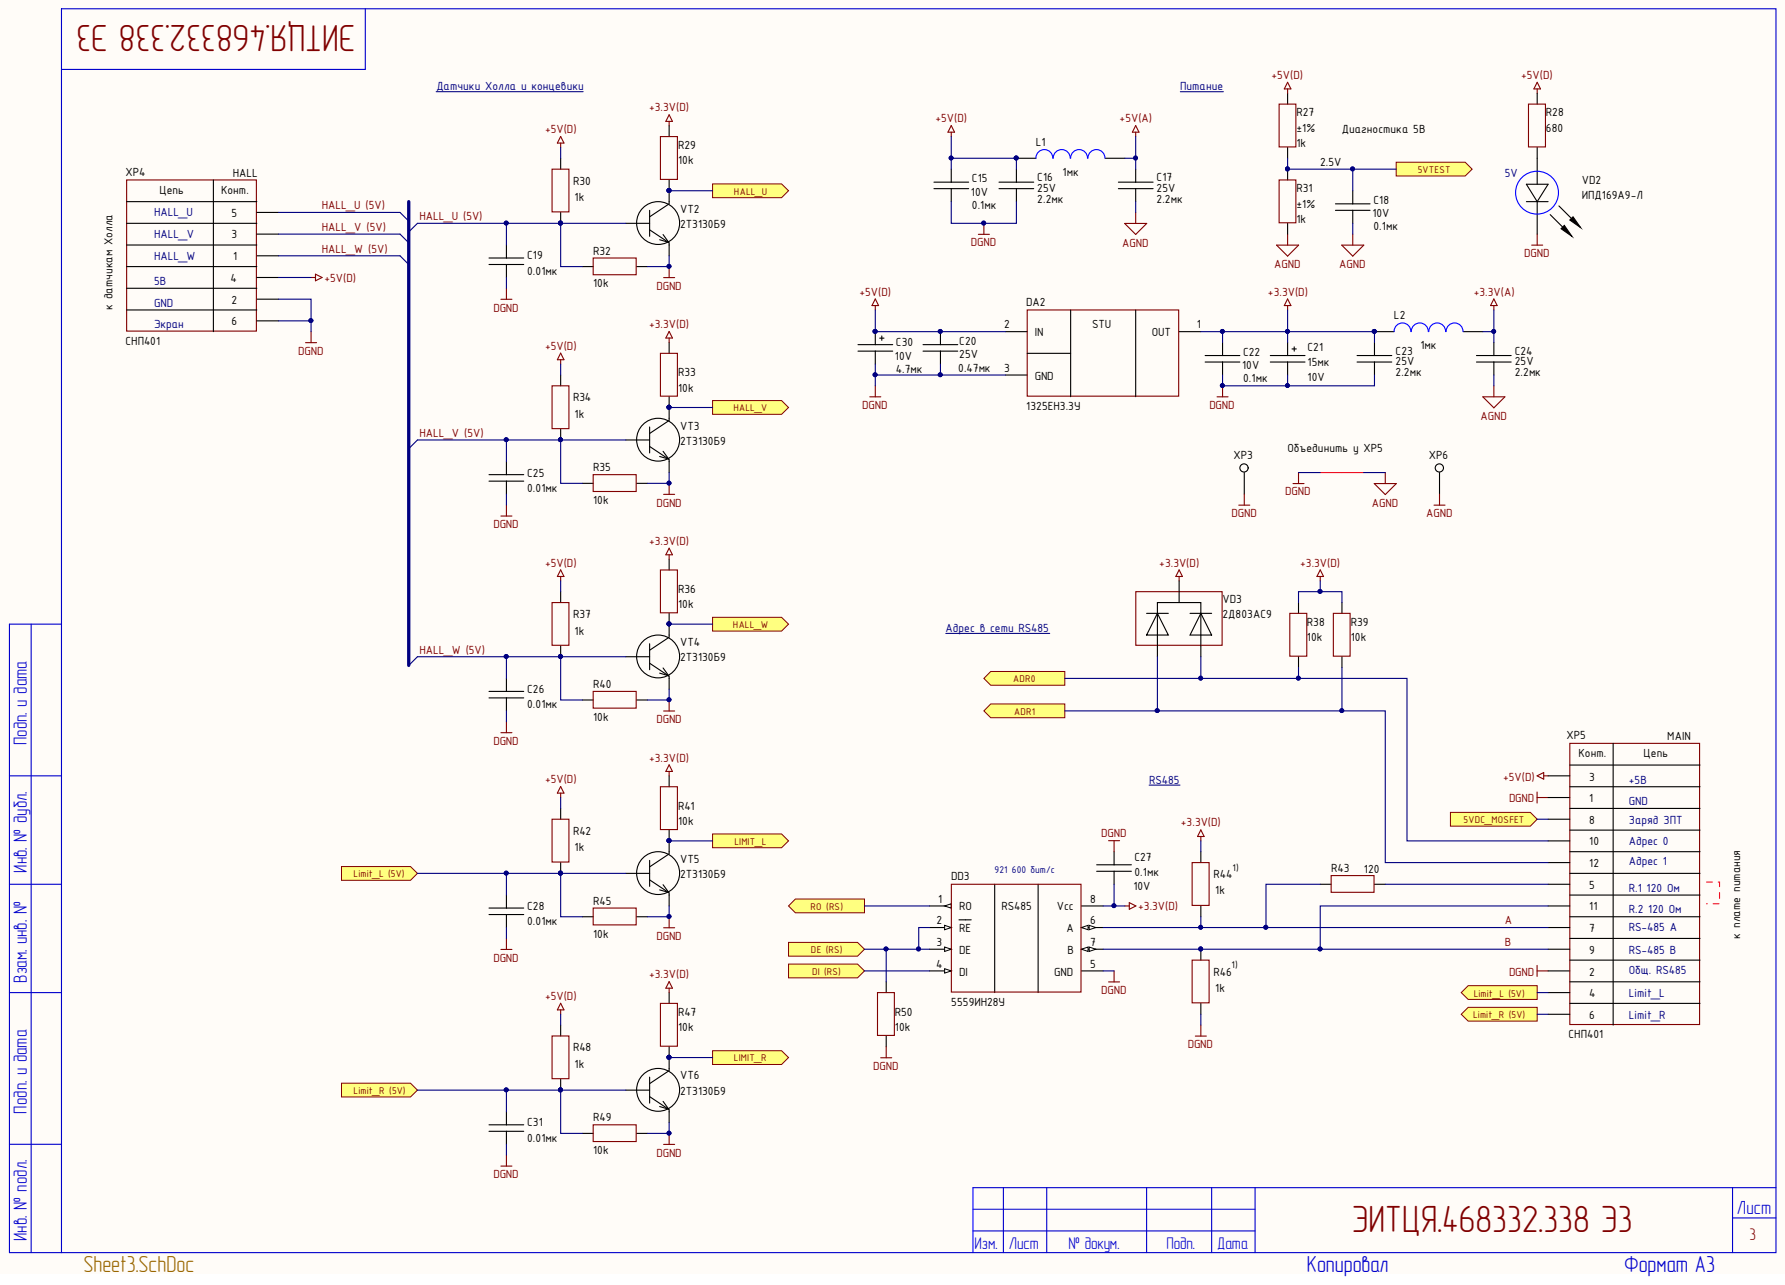
[picture p21: page 3]

GND | 2

Экран | 6

Инв. № подл. Подп. и дата Взам. инв. № Инв. № дубл. Подп. и дата

Конт. | Цепь

1 | GND

8 | Заряд ЗПТ

10 | Адрес 0
12 | Адрес 1

9 | RS-485 B
2 | Общ. RS485

4 | Limit_L

6 | Limit_R
