tihonov-e/Integrated_Servodriver/Doc/Search/D661497.pdf

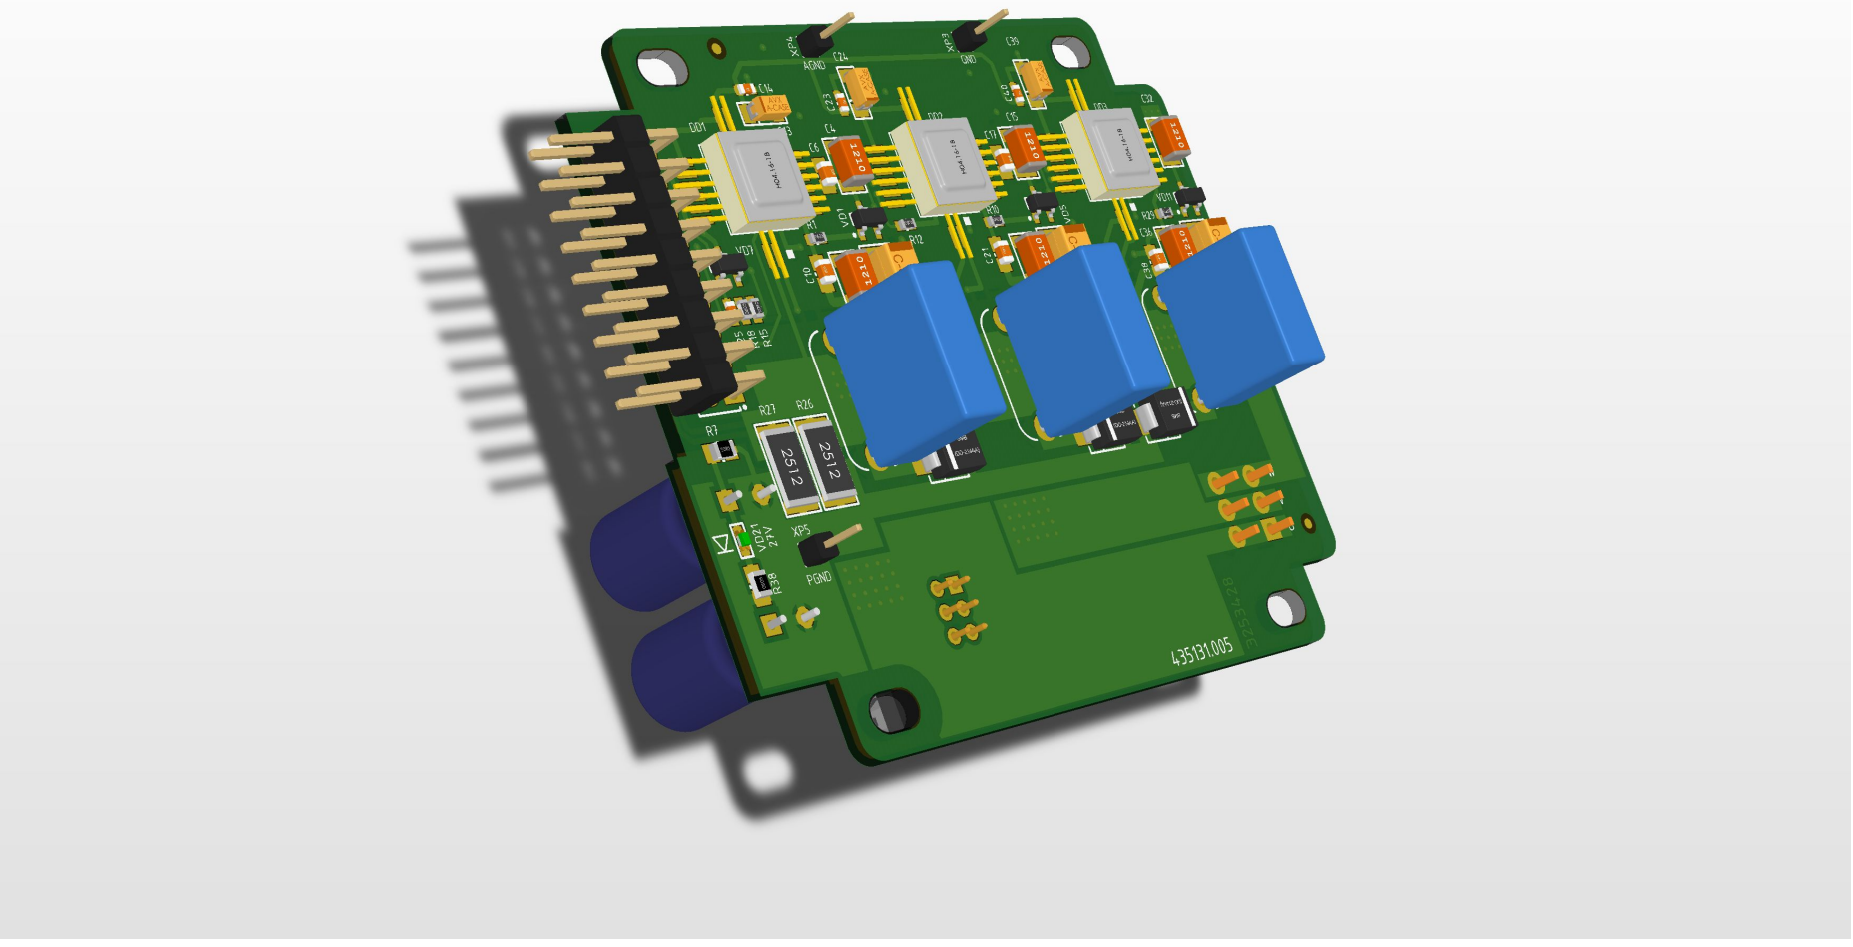
[picture p22: page 1]
