tihonov-e/Integrated_Servodriver/Altium Project/Power Unit/исходные данные для модуля силового ЭИТЦЯ.435131.005.pdf

# Модуль силовой ЭИТЦЯ.435131.005

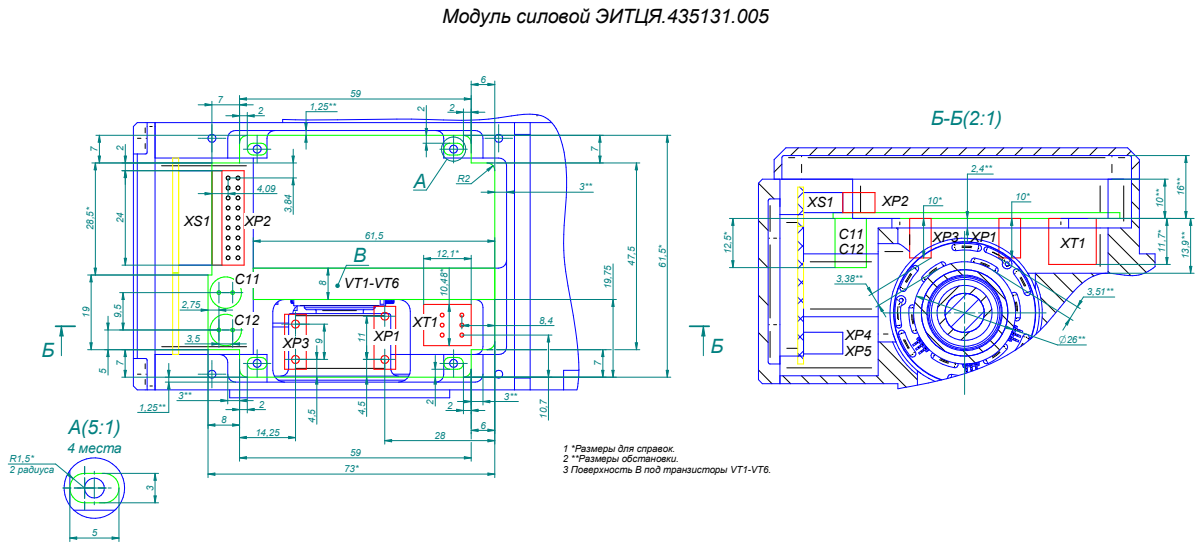
[picture p23: page 1]
4 места; R1,5* 2 радиуса

1 *Размеры для справок.
2 **Размеры обстановки.
3 Поверхность В под транзисторы VT1-VT6.
