tihonov-e/Integrated_Servodriver/Altium Project/Supply Unit/Исходные данные для модуля питания ЭИТЦЯ.436434.018.pdf

# Модуль питания ЭИТЦЯ.436434.018

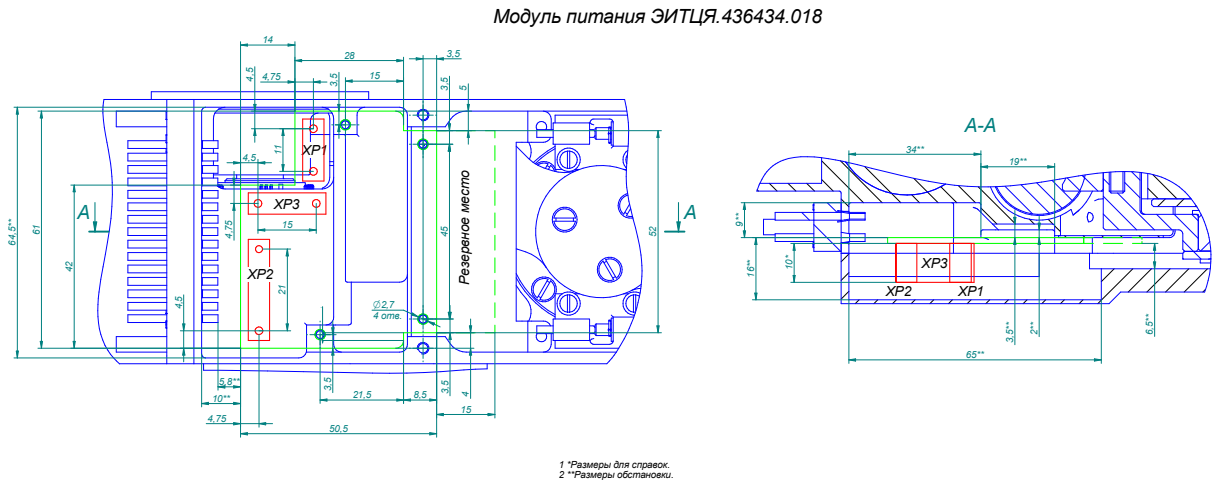
[picture p24: page 1]
2 Резервное место 2 А; 4 отв. 3,5

1 *Размеры для справок.
2 **Размеры обстановки.
