tihonov-e/Integrated_Servodriver/Altium Project/Control Unit/Исходные данные для Модуля управления ЭИТЦЯ.468332.338.pdf

Б

Б-Б(2:1)

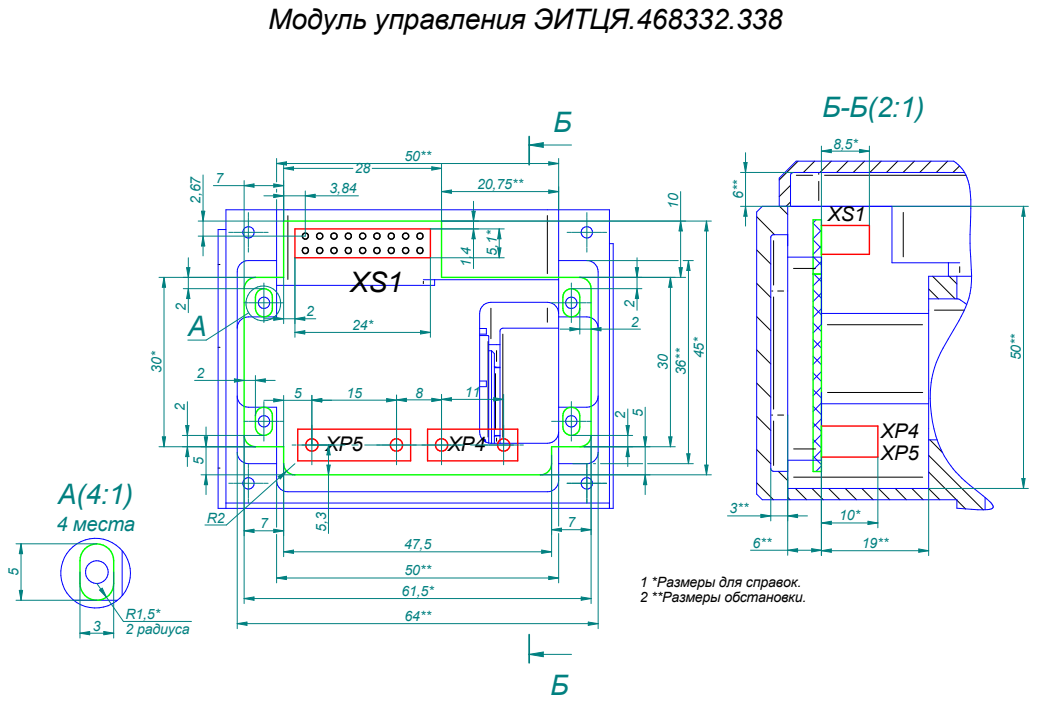
[picture p25: page 1]
4 места 30*; R1,5* 2 радиуса

Модуль управления ЭИТЦЯ.468332.338

1 *Размеры для справок.
2 **Размеры обстановки.
