tihonov-e/Integrated_Servodriver/(list of files, drawings)

Other design files:
Altium Project/Control Unit/Control_unit-RM.PrjPcb
Altium Project/Control Unit/PCB_control_unit.PcbLib
Altium Project/Control Unit/Region_CU.PrjPcb
Altium Project/Control Unit/Sheet1.SchDoc
Altium Project/Control Unit/Sheet2.SchDoc
Altium Project/Control Unit/Sheet3.SchDoc
Altium Project/Power Unit/PCB_power_unit.PcbLib
Altium Project/Power Unit/Power_unit-RM.PrjPcb
Altium Project/Power Unit/power_unit.SchDoc
Altium Project/Power Unit/Region_PU.PrjPcb
Altium Project/Supply Unit/PCB_supply unit.PcbLib
Altium Project/Supply Unit/Region_SU.PrjPcb
Altium Project/Supply Unit/Supply_unit-RM.PrjPcb
Altium Project/Supply Unit/Supply_unit-RM.SCHLIB
Altium Project/Supply Unit/supply_unit.SchDoc
Altium Project/Supply Unit/Архив/ver.1/Supply Unit/PCB_supply unit.PcbDoc
Altium Project/Supply Unit/Архив/ver.1/Supply Unit/Supply_unit-RM_1.PrjPcb
Altium Project/Supply Unit/Архив/ver.1/Supply Unit/supply_unit.SchDoc
Altium Project/Supply Unit/Архив/ver.2/Supply_unit-RM.PrjPcb
Altium Project/Supply Unit/Архив/ver.2/supply_unit.SchDoc
