tihonov-e/Integrated_Servodriver/(commit log)

2019-11-17 updated cap to K10-84
    [Region_CU.PrjPcb, Region_PU.PrjPcb, Sheet1.SchDoc, Sheet2.SchDoc, Sheet3.SchDoc]
2019-11-19 added Supply Unit
    [Region_SU.PrjPcb, Sheet1.SchDoc, Sheet2.SchDoc, Sheet3.SchDoc]
2019-11-23 all 3 schematics are ready to make a BOMs
    [Control_unit-RM.PrjPcb, Power_unit-RM.PrjPcb, Sheet1.SchDoc, Sheet2.SchDoc, Sheet3.SchDoc, Supply_unit-RM.PrjPcb, power_unit.SchDoc, supply_unit.SchDoc]
2019-11-23 BOMs have finished
    [Control_unit-RM.PrjPcb, Control_unit-RM.xls, PowerUnit_BOM.xls, Power_unit-RM.PrjPcb, Power_unit-RM.xls, Sheet1.SchDoc, Sheet2.SchDoc, Sheet3.SchDoc]
2019-11-28 D2PAK installed on PCB
    [Control_unit-RM.PrjPcb, Power_unit-RM.PrjPcb, Sheet1.SchDoc, Sheet3.SchDoc, Supply_unit-RM.PrjPcb, power_unit.SchDoc, supply_unit.SchDoc]
2019-12-01 placement finished
    [Power_unit-RM.PrjPcb, Sheet2.SchDoc, Sheet3.SchDoc, power_unit.SchDoc, supply_unit.SchDoc]
2019-12-04 Power Unit: - update board dimensions - changed gate resistors from 10 to 20 Ohm - changed filter cap for analog signals from 2200p to 0.01u - added XP3 for the limit swithes - changed XP2 to 18 pins
    Control unit
    - added SPI for service connector
    - added Flash ereasing jumper XP6
    - changed comparator reference from 1.65 to 2.2V (R2 = 2k)
    - changed C12 to 0.01u
    - changed XS1 to 18pin
    - changed XP4 to 6pin
    - limit swiches now comes from power unit through XS1
    - added pull-down R50 for the DE1(RS) signal
    [Sheet1.SchDoc, Sheet2.SchDoc, Sheet3.SchDoc, power_unit.SchDoc, supply_unit.SchDoc]
2019-12-08 - добавлена папка расчеты - на pcb сформированы функциональные узлы
    [Sheet3.SchDoc, power_unit.SchDoc, true DC-bus cap!!!.xlsx, Зазоры между проводниками vs Напряжение.xls, Расчет DCDC.xlsx, Расчет заряда DCBUS.xlsx, Расчет силовой части_JCM38x12_KUBO_D2PAK.xlsx, Расчет силовой части_JCM38x12_KUBO_DPAK.xlsx]
2019-12-18 - обновлены контуры плат по последним эскизам от конструктора - расставлены компоненты по эскизам - переделана схемотехника платы питания (на DCDC Aedon) - разведена плата управления
    [Control_unit-RM.PrjPcb, PCB_supply unit.PcbDoc, Power_unit-RM.PrjPcb, Sheet1.SchDoc, Sheet2.SchDoc, Sheet3.SchDoc, Supply_unit-RM-2.PrjPcb And Supply_unit-RM-2.XLS, Supply_unit-RM.PrjPcb]
2019-12-24 - концевики прокинуты через плату питания - плата питания готова к проверке - плата управления требует доразводки в части крепежных отверстий - плата силовая в дрова
    [Control_unit-RM.PrjPcb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]
2020-01-09 Закончены все три платы
    [Control_unit-RM.PrjPcb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]
2020-01-13 исправлены замечания Соколова
    [PCB_control_unit.GBL, PCB_control_unit.GBO, PCB_control_unit.GTL, PCB_control_unit.GTO, PCB_control_unit.GTS, PCB_power_unit.GTL, PCB_power_unit.GTO, PCB_power_unit.GTS]
2020-01-21 reserve commit before Windows update
    [Control_unit-RM.PrjPcb, Power_unit-RM.PrjPcb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]
2020-02-26 КД в архиве
    [Control_unit-RM.PrjPcb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]
